Terrapin-Rocket-Team/Airbrake/Wiring_Diagram/Pictures/MotorControlerIn.png

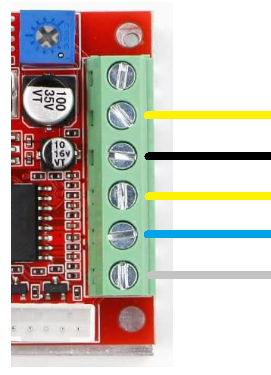
Wiring_Diagram/Pictures/MotorControlerIn.png
