Terrapin-Rocket-Team/Airbrake/Wiring_Diagram/Pictures/BlueRaven.png

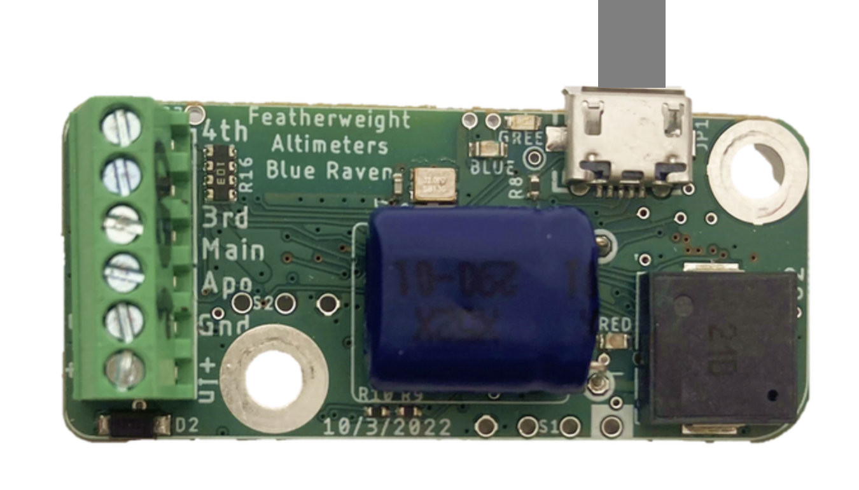
Wiring_Diagram/Pictures/BlueRaven.png
