Terrapin-Rocket-Team/Airbrake/Astra-Rocket/hitl_altitude_comparison.png

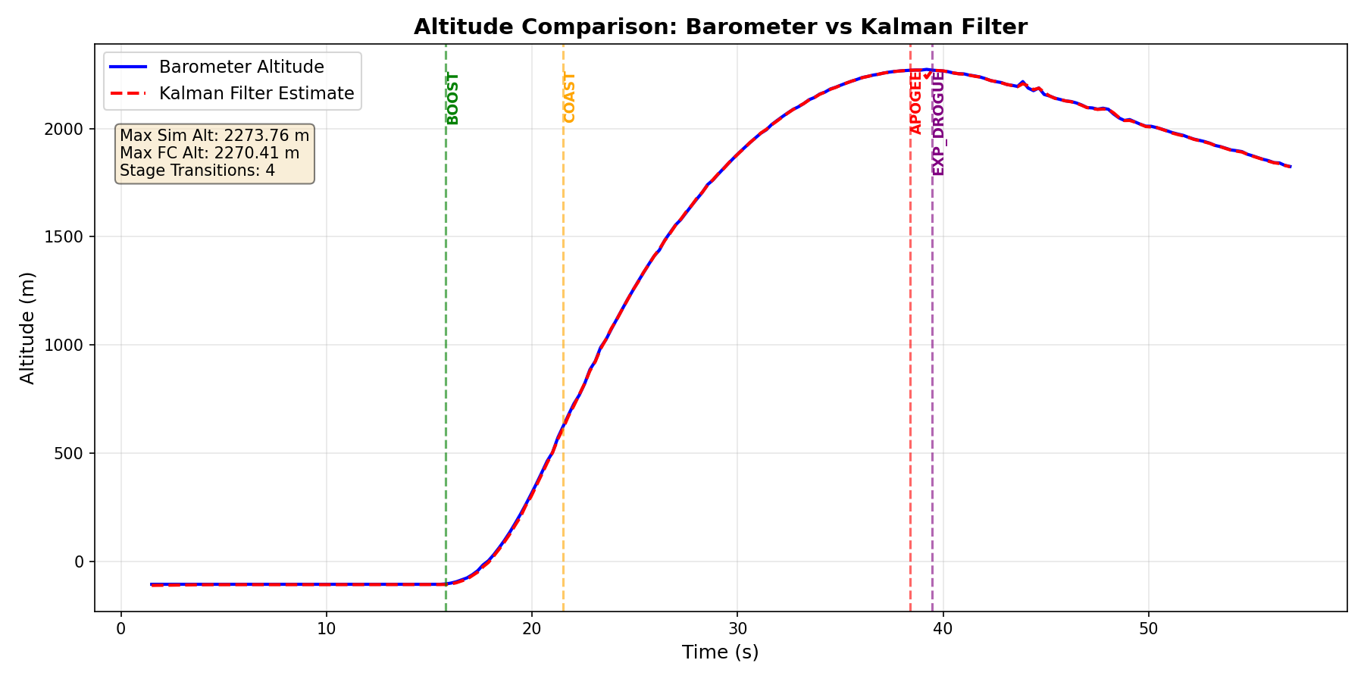
Astra-Rocket/hitl_altitude_comparison.png
