Terrapin-Rocket-Team/Airbrake/flap_force/Force_Geometry.png

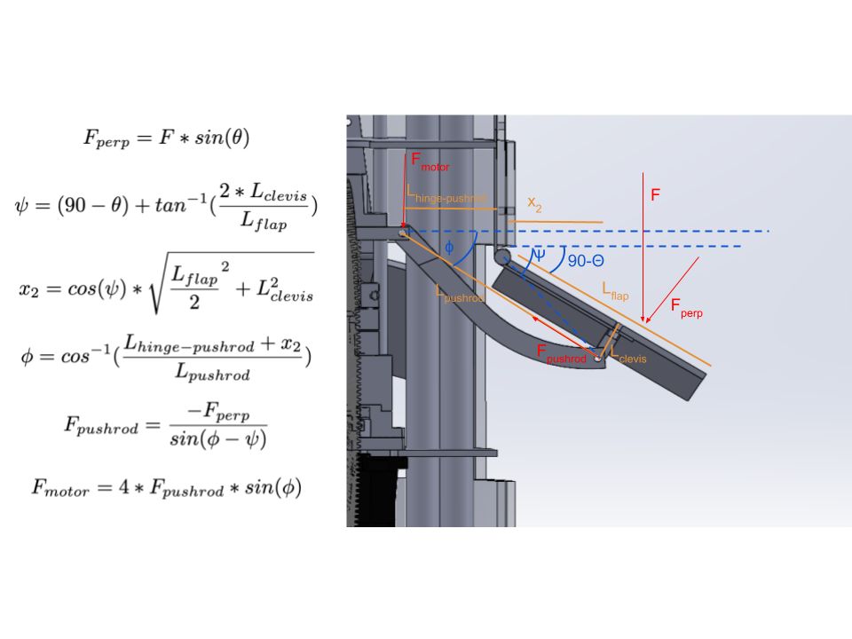
flap_force/Force_Geometry.png
