Terrapin-Rocket-Team/Airbrake/flap_force/output/max_flap_angle_vs_drag_force.png

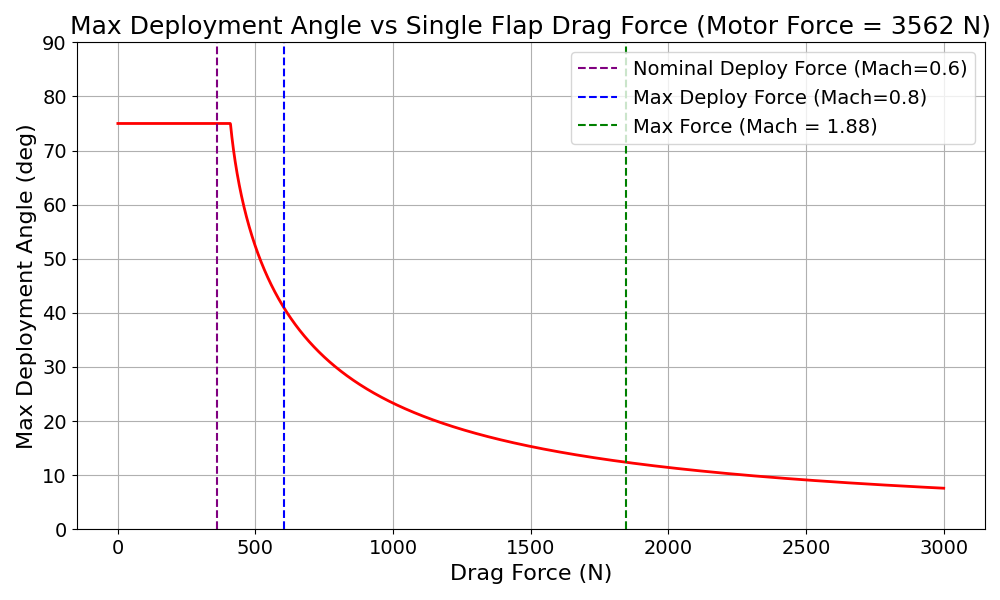
flap_force/output/max_flap_angle_vs_drag_force.png
