Terrapin-Rocket-Team/Airbrake/HITL/graphs/5-22-25_Interior_Full_plot.png

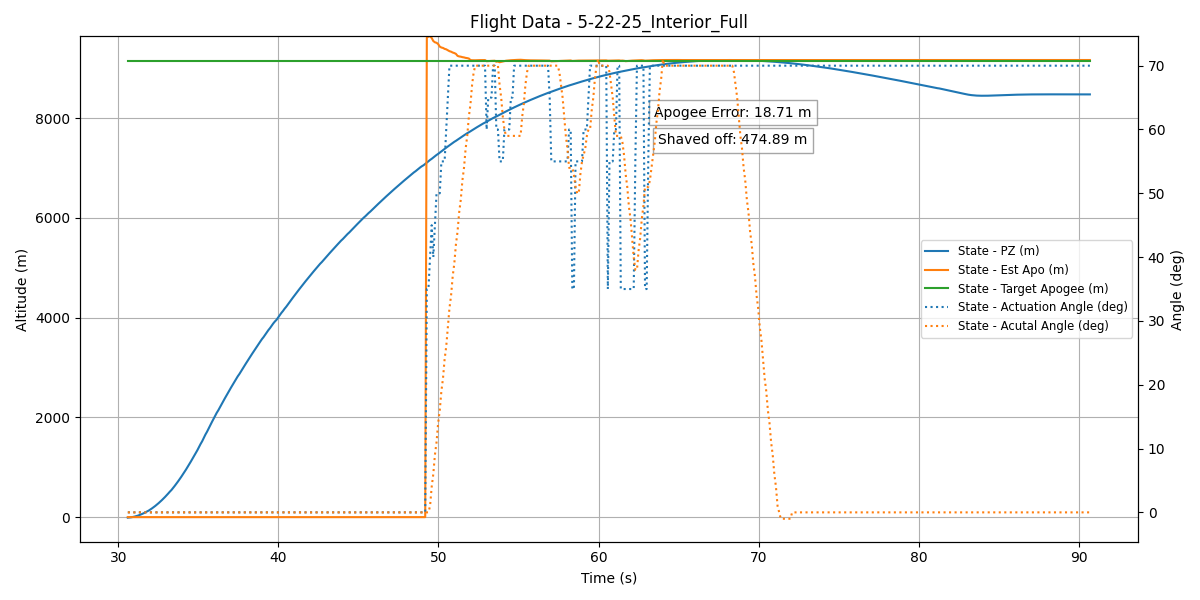
HITL/graphs/5-22-25_Interior_Full_plot.png
