Terrapin-Rocket-Team/Airbrake/HITL/graphs/5-22-25_No_Flap_plot.png

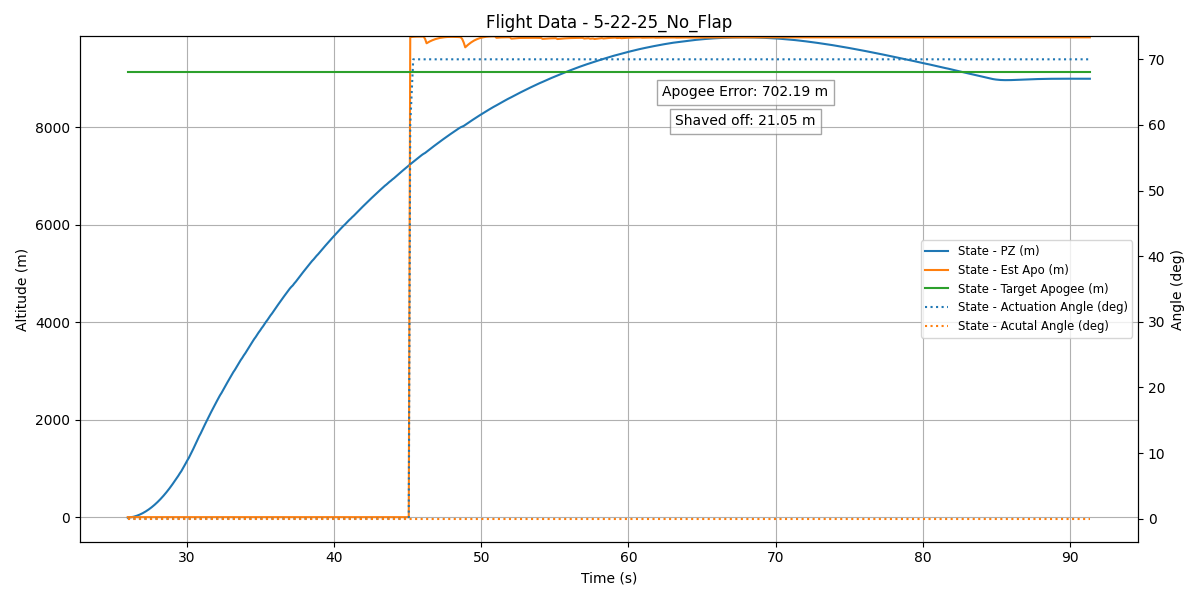
HITL/graphs/5-22-25_No_Flap_plot.png
