Terrapin-Rocket-Team/Airbrake/HITL/graphs/5-25-25_fixed_CdA_estimation_plot.png

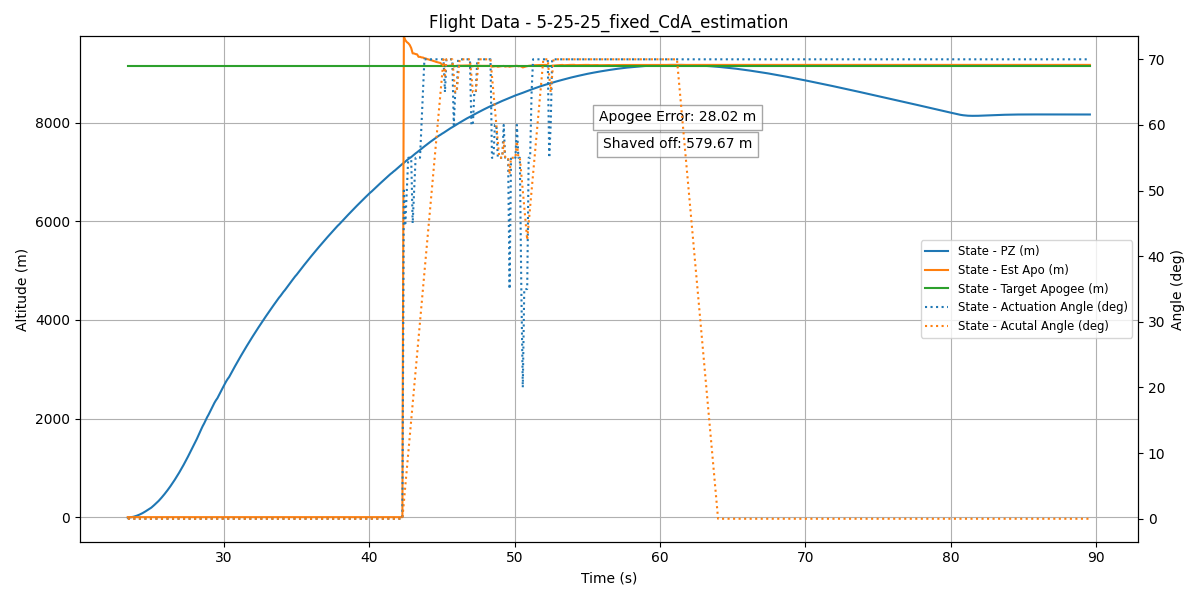
HITL/graphs/5-25-25_fixed_CdA_estimation_plot.png
