Terrapin-Rocket-Team/Airbrake/HITL/graphs/5-31-25_supersonic_not_accounted_for_plot.png

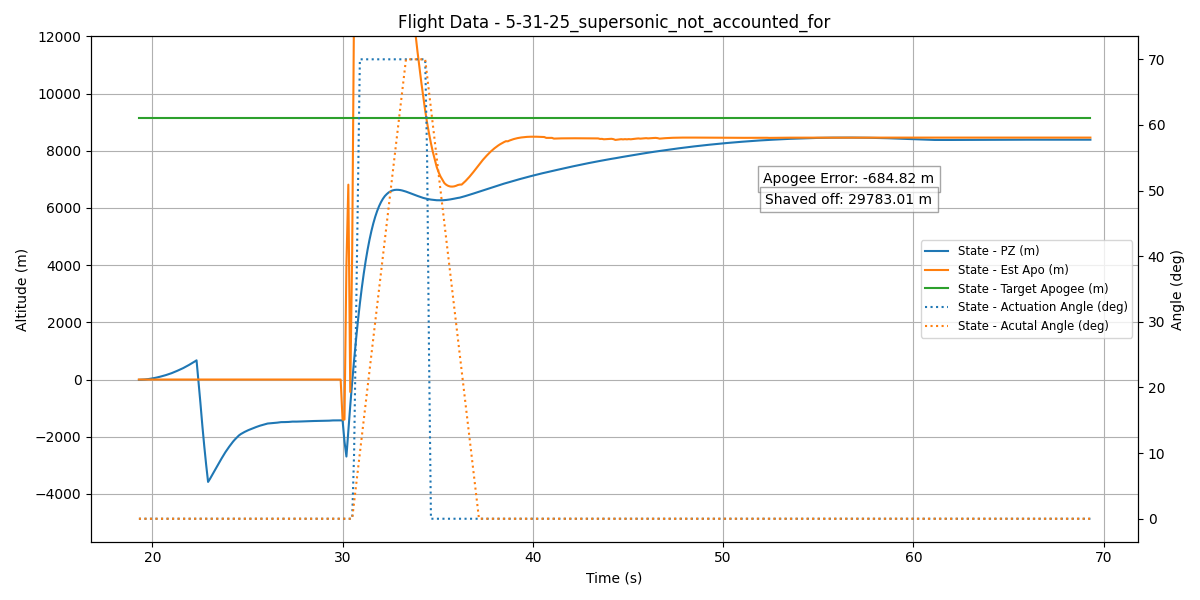
HITL/graphs/5-31-25_supersonic_not_accounted_for_plot.png
