Terrapin-Rocket-Team/Airbrake/HITL/graphs/5-31-25_supersonic_simple_filter_plot.png

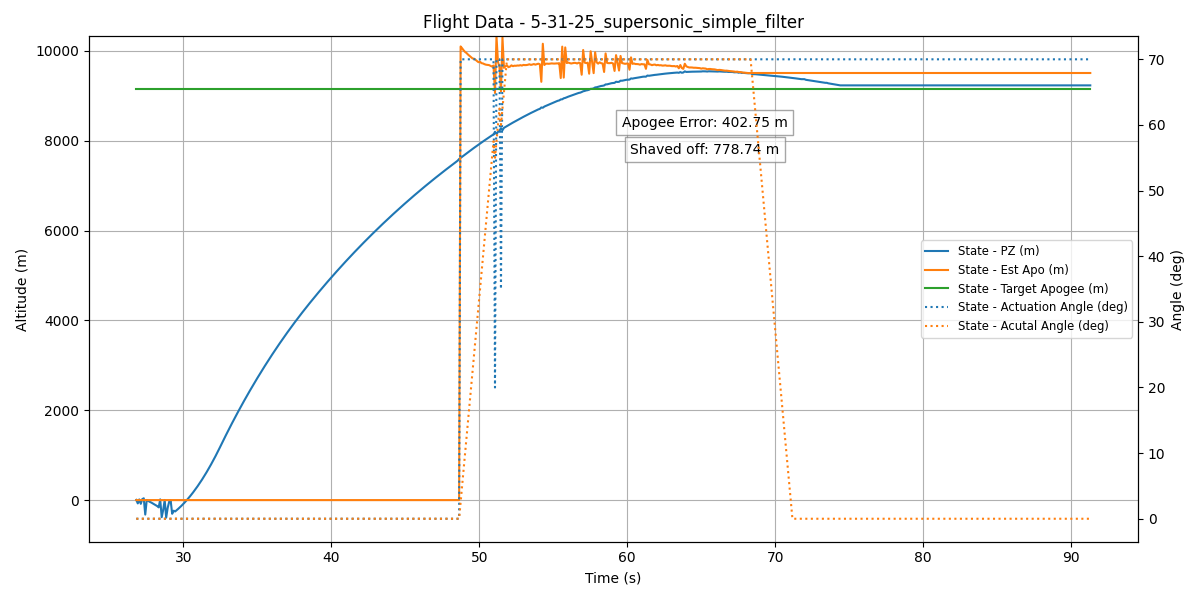
HITL/graphs/5-31-25_supersonic_simple_filter_plot.png
