Terrapin-Rocket-Team/Airbrake/HITL/graphs/6-6-25_full_airbrake_no_supersonic_plot.png

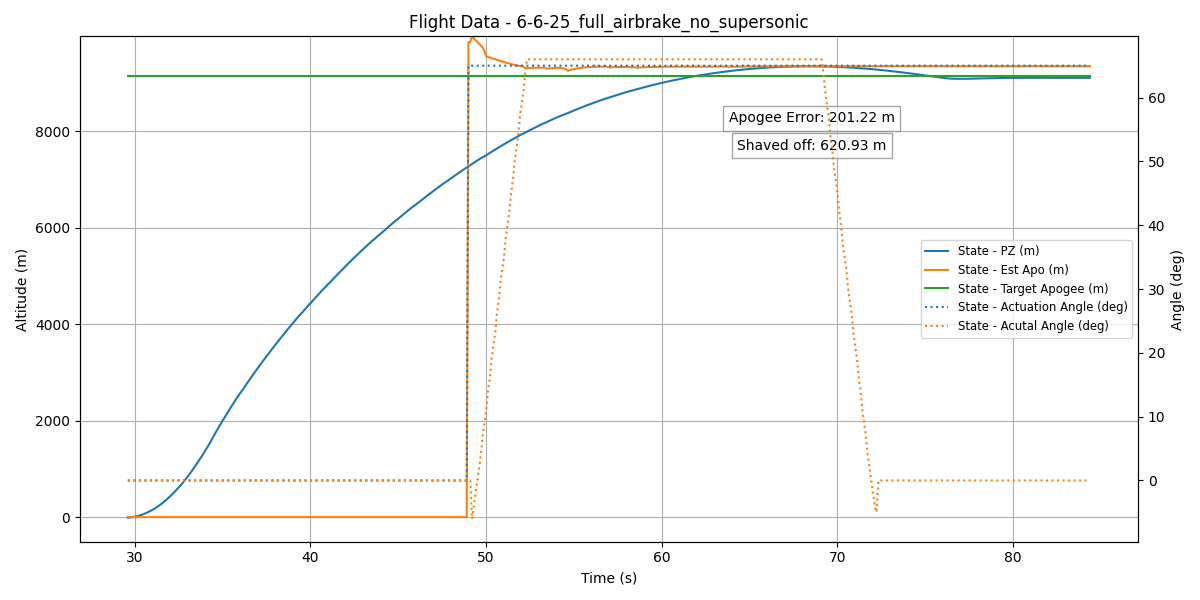
HITL/graphs/6-6-25_full_airbrake_no_supersonic_plot.png
