Terrapin-Rocket-Team/Airbrake/HITL/graphs/6-8-25_full_airbrake_ideal_plot.png

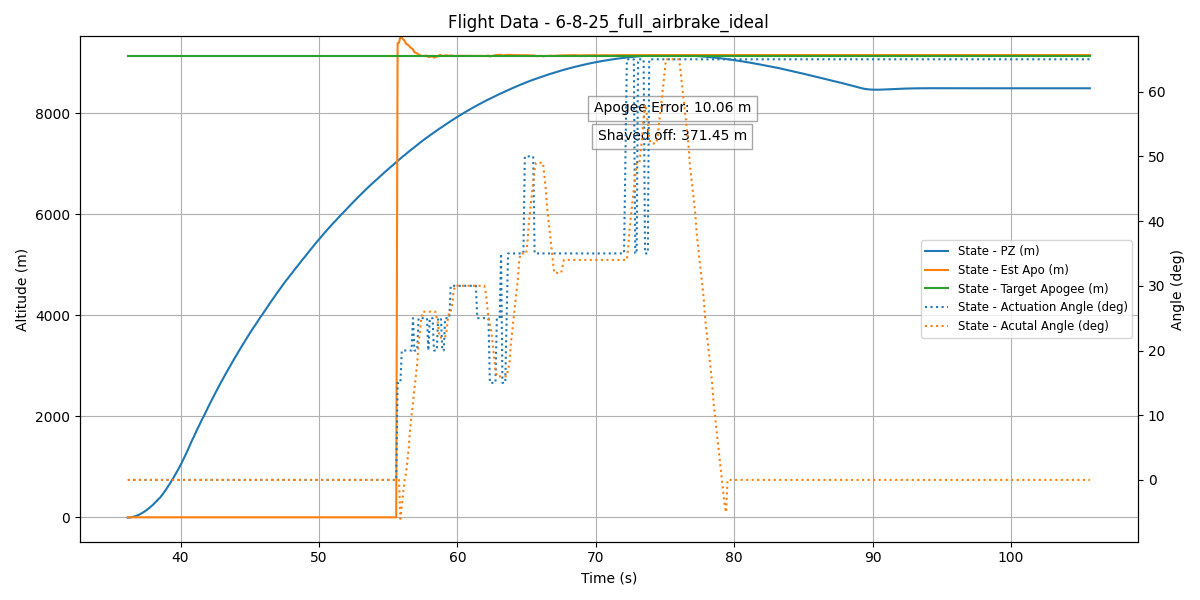
HITL/graphs/6-8-25_full_airbrake_ideal_plot.png
