Terrapin-Rocket-Team/Airbrake/HITL/graphs/6-8-25_ideal_again_plot.png

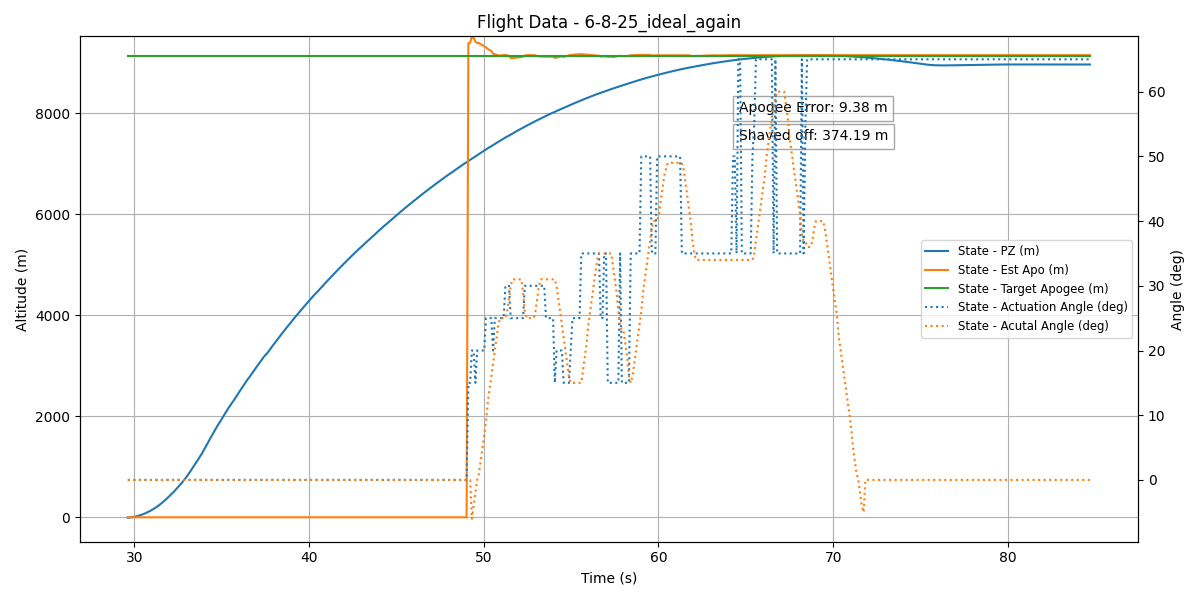
HITL/graphs/6-8-25_ideal_again_plot.png
