Terrapin-Rocket-Team/Airbrake/HITL/graphs/6-8-25_ideal_full_flight_plot.png

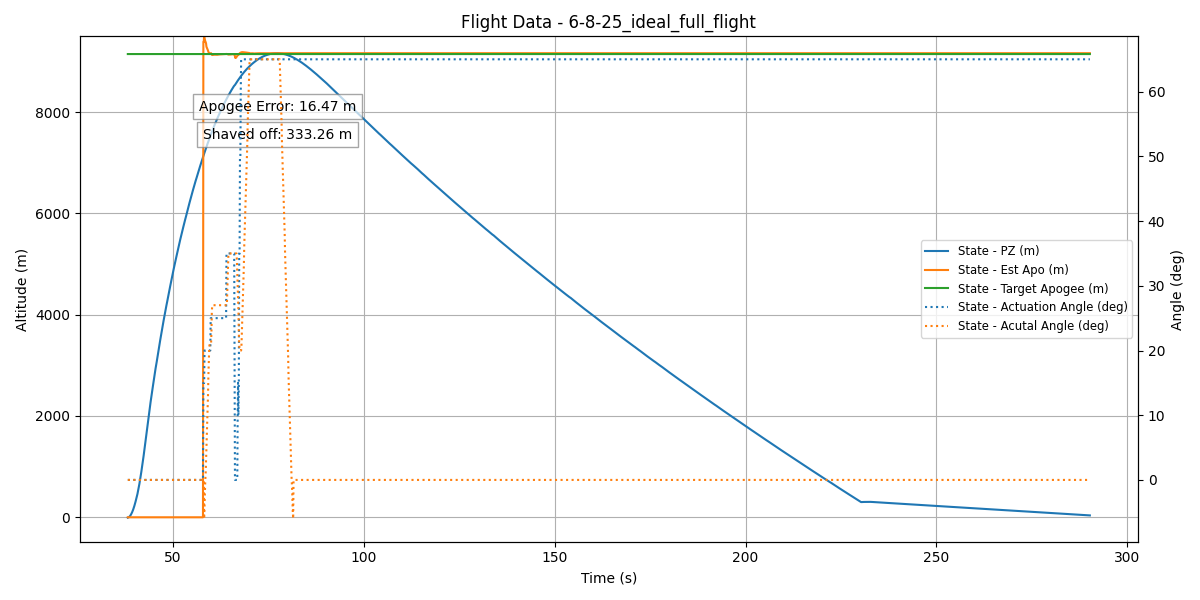
HITL/graphs/6-8-25_ideal_full_flight_plot.png
