Terrapin-Rocket-Team/Airbrake/HITL/graphs/6-8-25_worst_case_motor_plot.png

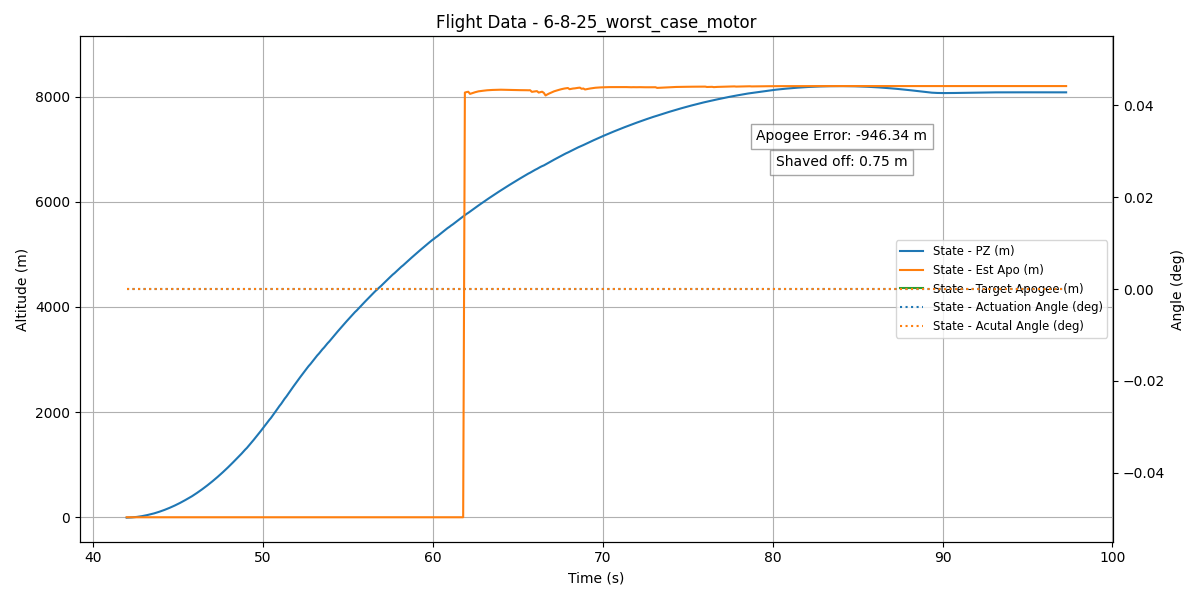
HITL/graphs/6-8-25_worst_case_motor_plot.png
