Terrapin-Rocket-Team/Airbrake/HITL/graphs/6-10-25_final_simulation_plot.png

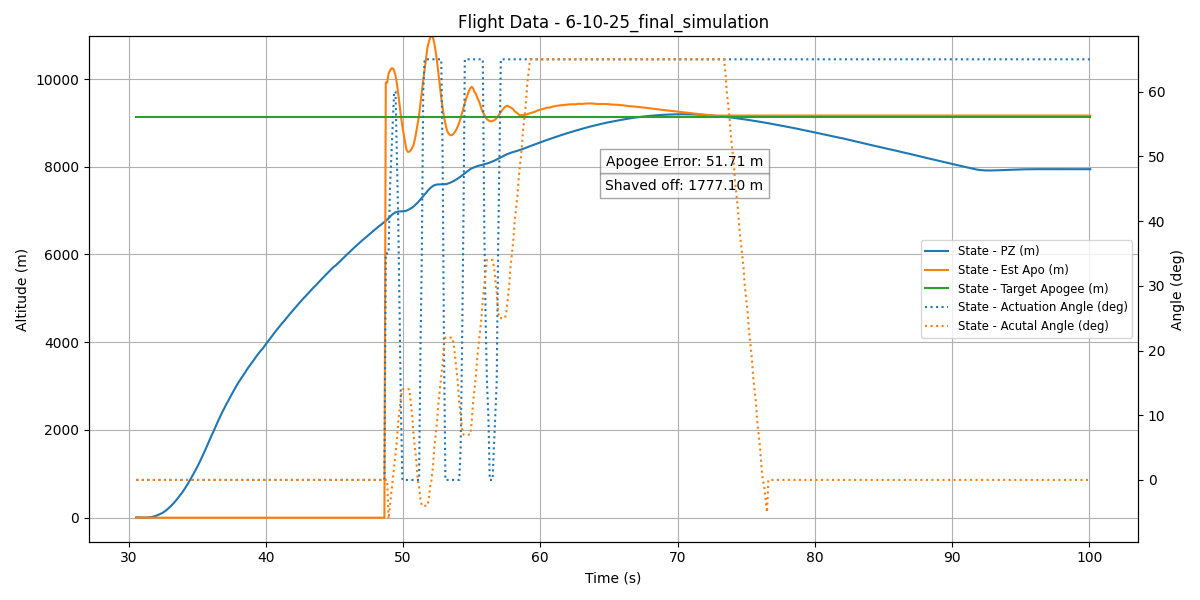
HITL/graphs/6-10-25_final_simulation_plot.png
