Terrapin-Rocket-Team/Airbrake/HITL/graphs/HITL-Airbrake_plot.png

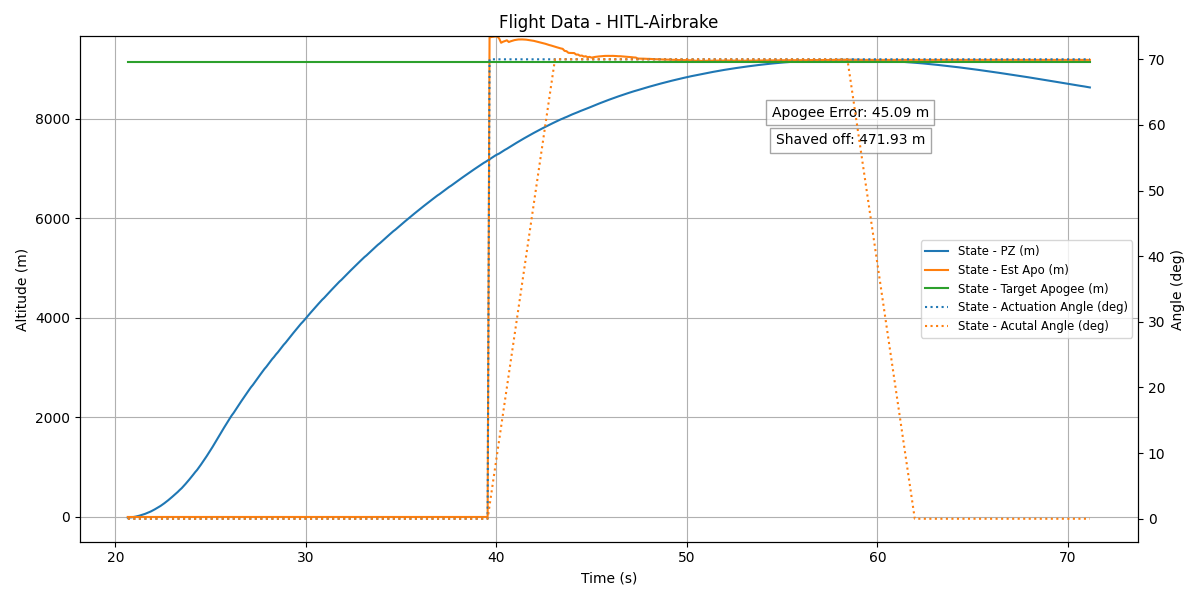
HITL/graphs/HITL-Airbrake_plot.png
