Terrapin-Rocket-Team/Airbrake/Concept_ CAD/Assembly.SLDASM

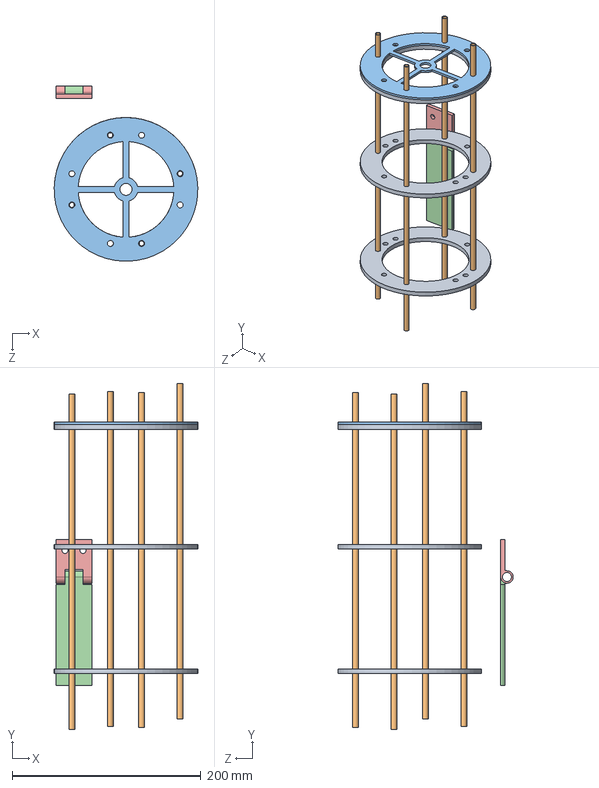
[picture p20: CAD file, 2024-07-18]
Concept_ CAD/Assembly.SLDASM
152.3 x 366.9 x 186.1 mm
Bulkhead x 3
Carbon_Fibre_Rod x 4
Bulkhead_Top
Hinge_Bottom
Hinge_Top
