Terrapin-Rocket-Team/Airbrake/Concept_ CAD/Flap_Assembly.SLDASM

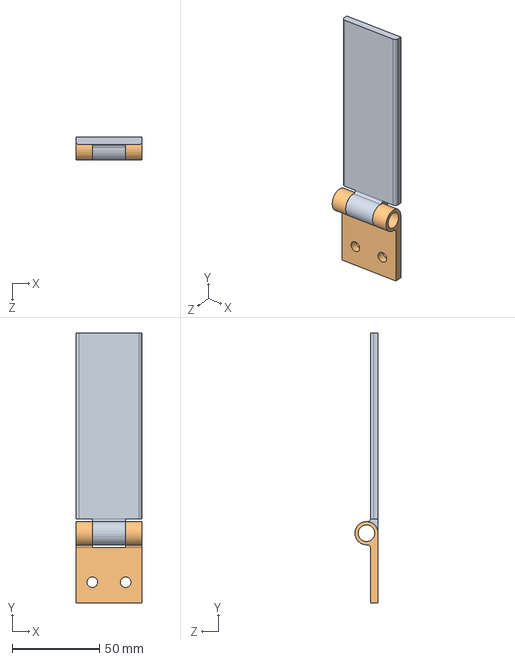
[picture p21: CAD file, 2024-07-18]
Concept_ CAD/Flap_Assembly.SLDASM
38.1 x 154.9 x 13.3 mm
Hinge_Bottom
Hinge_Top
