Terrapin-Rocket-Team/Airbrake/PCBs/Airbrake_ComputeBoard/Airbrake_ComputeBoard_v1_2.step

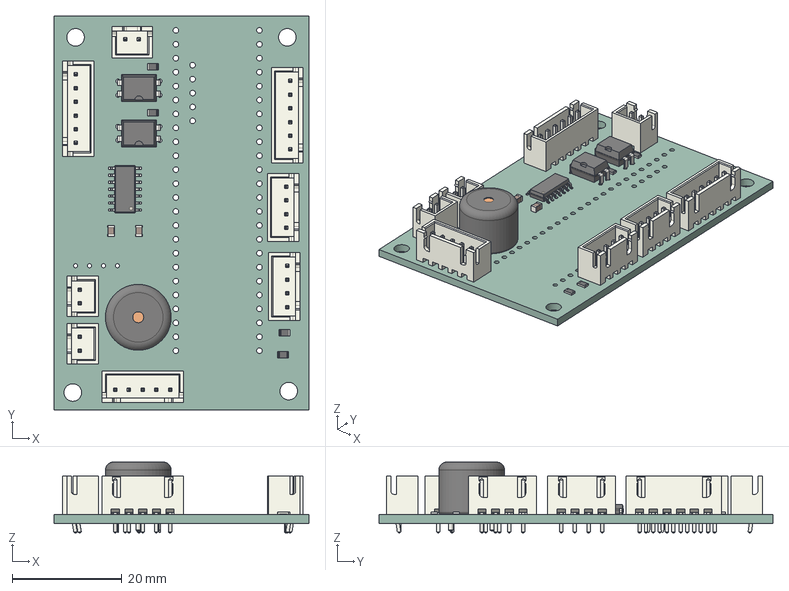
[picture p22: CAD file, 2024-12-22]
PCBs/Airbrake_ComputeBoard/Airbrake_ComputeBoard_v1_2.step
46.5 x 71.8 x 12.9 mm
DIP-4_W7.62mm x 2
JST_B5B_XH_A
SOIC_14_39x87mm_P127mm
Buzzer_12x95RM76
R_0805_2012Metric x 4
JST_B6B_XH_A x 2
C_0805_2012Metric x 2
JST_B2B_XH_A x 3
JST_B4B_XH_A x 2
Airbrake_ComputeBoard_PCB
