Terrapin-Rocket-Team/Airbrake/TRT2303 - Airbrake/Air brake assembly/STEP/Flap_top.stp

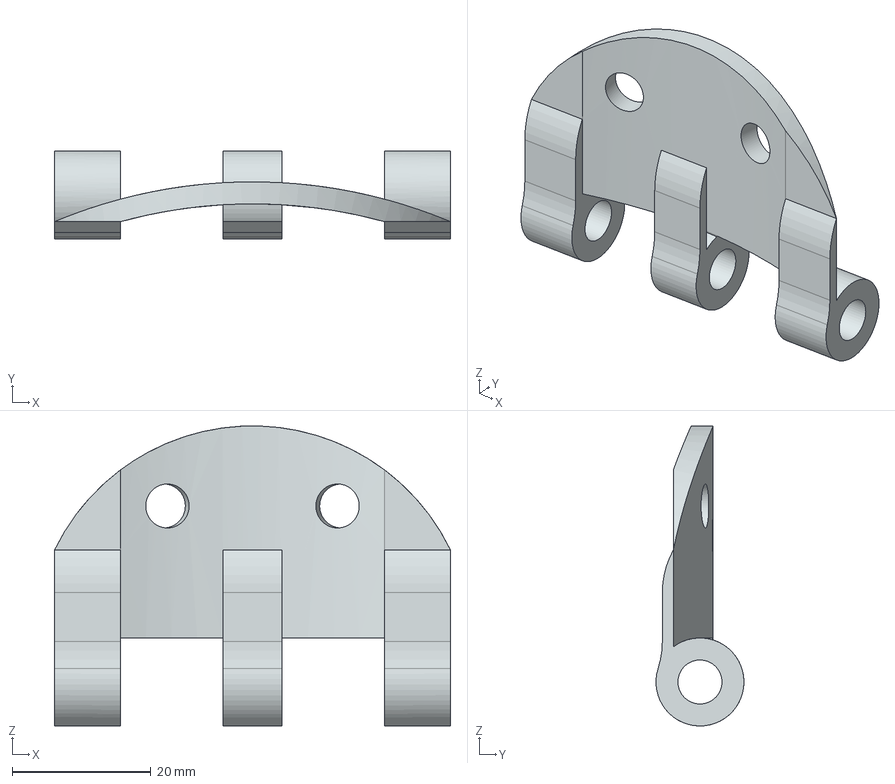
[picture p23: CAD file, 2024-07-18]
TRT2303 - Airbrake/Air brake assembly/STEP/Flap_top.stp
57.2 x 12.7 x 43.3 mm
