Terrapin-Rocket-Team/Airbrake/TRT2303 - Airbrake/Air brake assembly/stl/sting_hole_guide.stl

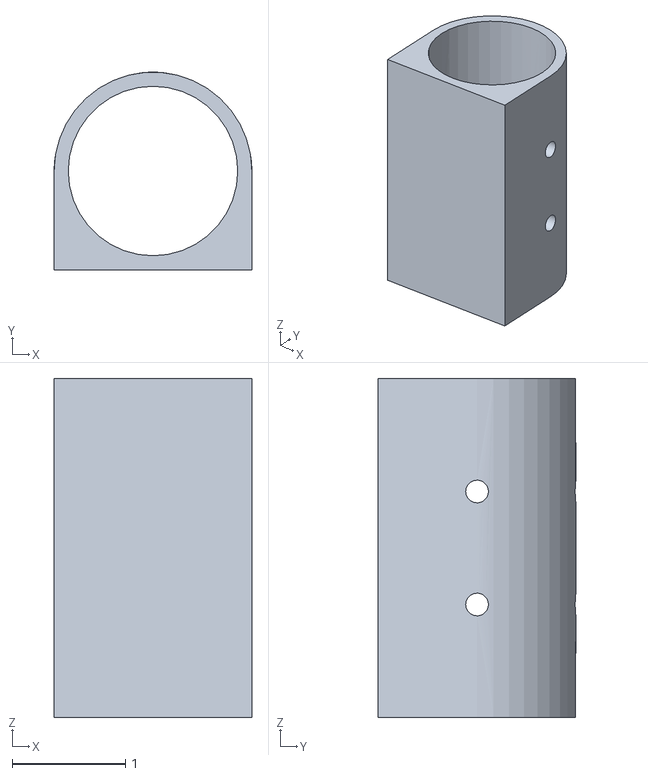
[picture p24: CAD file, 2024-07-18]
TRT2303 - Airbrake/Air brake assembly/stl/sting_hole_guide.stl
1.75 x 1.75 x 3.00
