Terrapin-Rocket-Team/Airbrake/TRT2303 - Airbrake/New Parts/inner bulkhead.STL

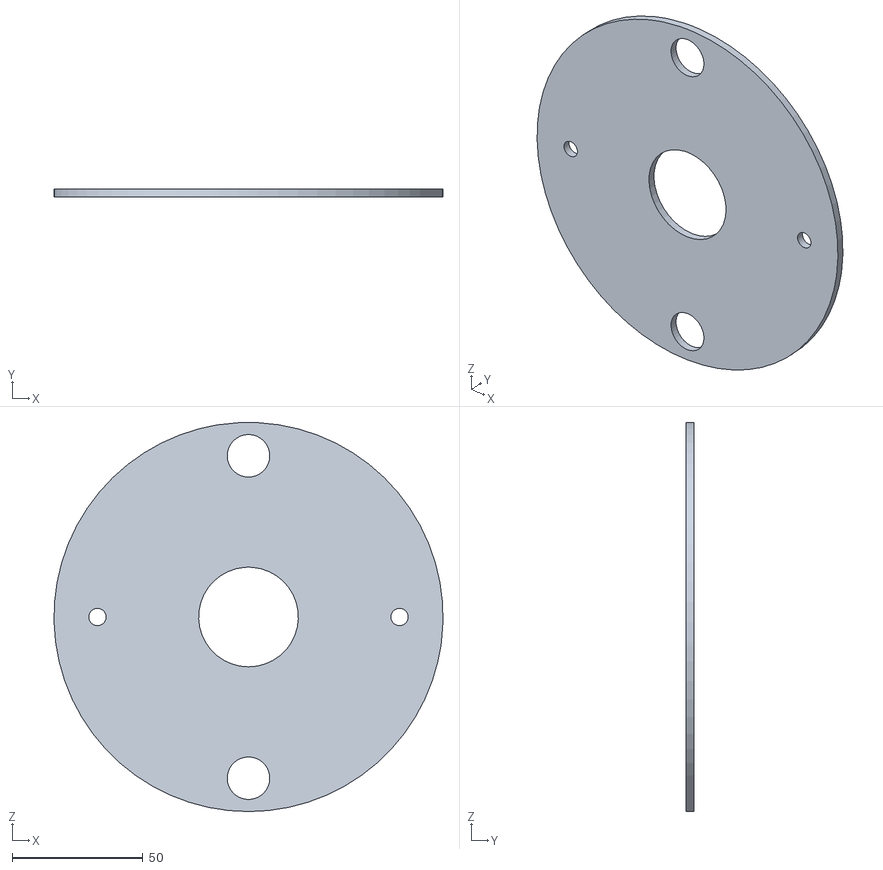
[picture p25: CAD file, 2024-07-18]
TRT2303 - Airbrake/New Parts/inner bulkhead.STL
148.7 x 3.17 x 148.7
