Terrapin-Rocket-Team/Airbrake/TRT2303 - Airbrake/Wind tunnel test stand/DXF files/lower_recovery_tube_centering_ring.dxf

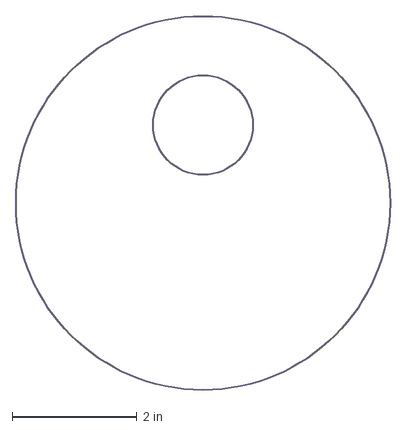
[picture p26: CAD file, 2024-07-18]
TRT2303 - Airbrake/Wind tunnel test stand/DXF files/lower_recovery_tube_centering_ring.dxf
6.00 x 6.00 in
