Terrapin-Rocket-Team/Airbrake/Concept_ CAD/Carbon_Fibre_Rod.SLDPRT

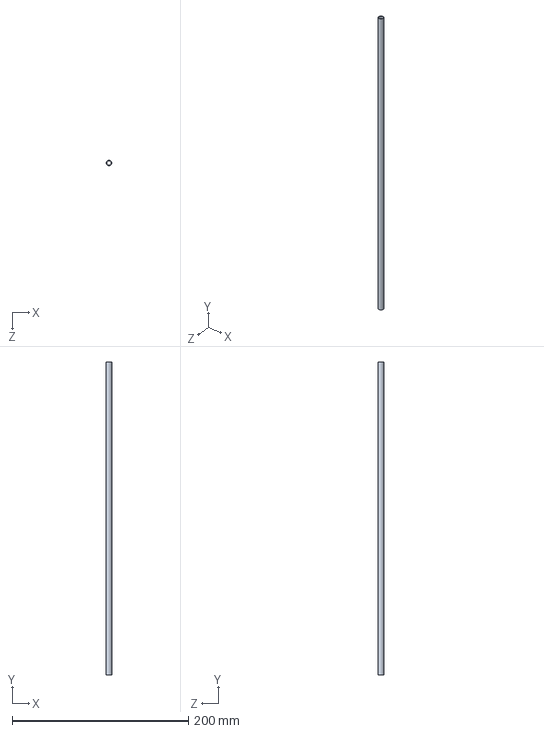
[picture p27: CAD file, 2024-07-18]
Concept_ CAD/Carbon_Fibre_Rod.SLDPRT
6.35 x 355.6 x 6.35 mm
