Terrapin-Rocket-Team/Airbrake/TRT2303 - Airbrake/Air brake assembly/STEP/Flap_bottom.stp

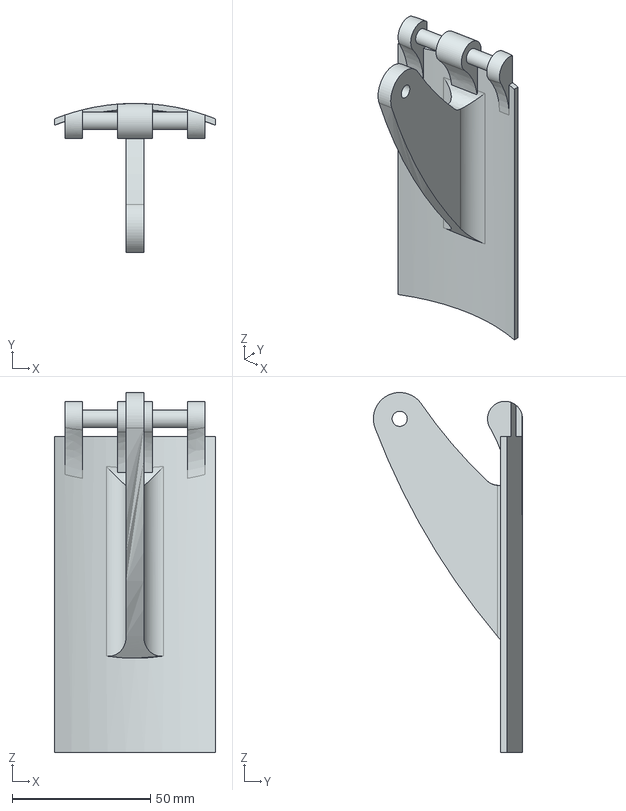
[picture p28: CAD file, 2024-07-18]
TRT2303 - Airbrake/Air brake assembly/STEP/Flap_bottom.stp
58.3 x 54.0 x 130.2 mm
