Terrapin-Rocket-Team/Airbrake/Concept_ CAD/Bulkhead_Top.SLDPRT

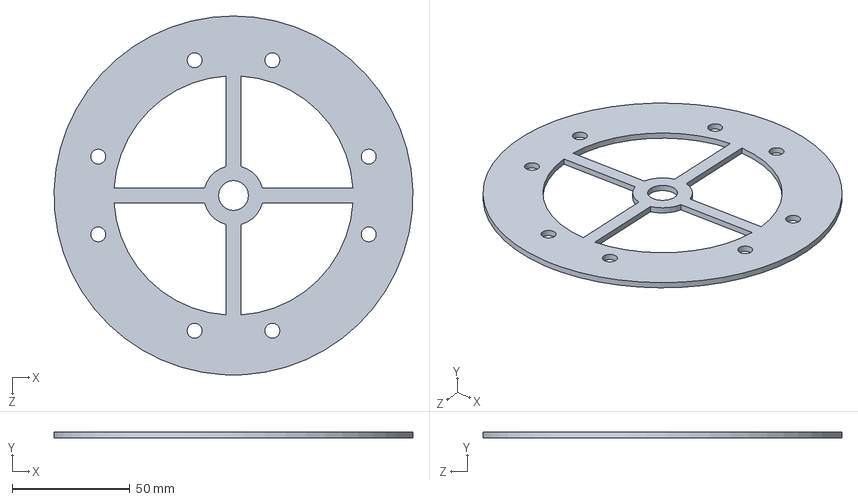
[picture p29: CAD file, 2024-07-18]
Concept_ CAD/Bulkhead_Top.SLDPRT
152.3 x 2.54 x 152.4 mm
