Terrapin-Rocket-Team/Airbrake/TRT2303 - Airbrake/Air brake assembly/Coupler.stp

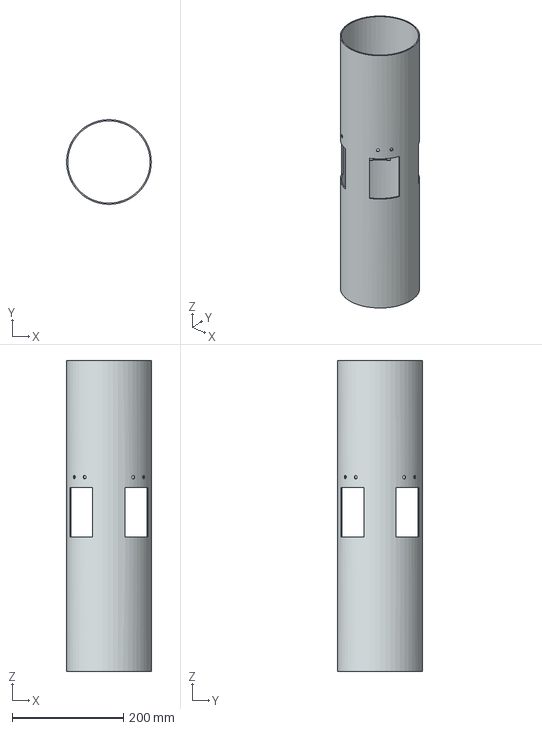
[picture p30: CAD file, 2024-07-18]
TRT2303 - Airbrake/Air brake assembly/Coupler.stp
152.2 x 152.3 x 558.8 mm
