Terrapin-Rocket-Team/Airbrake/TRT2303 - Airbrake/Air brake assembly/STEP/flap horn and hinge.stp

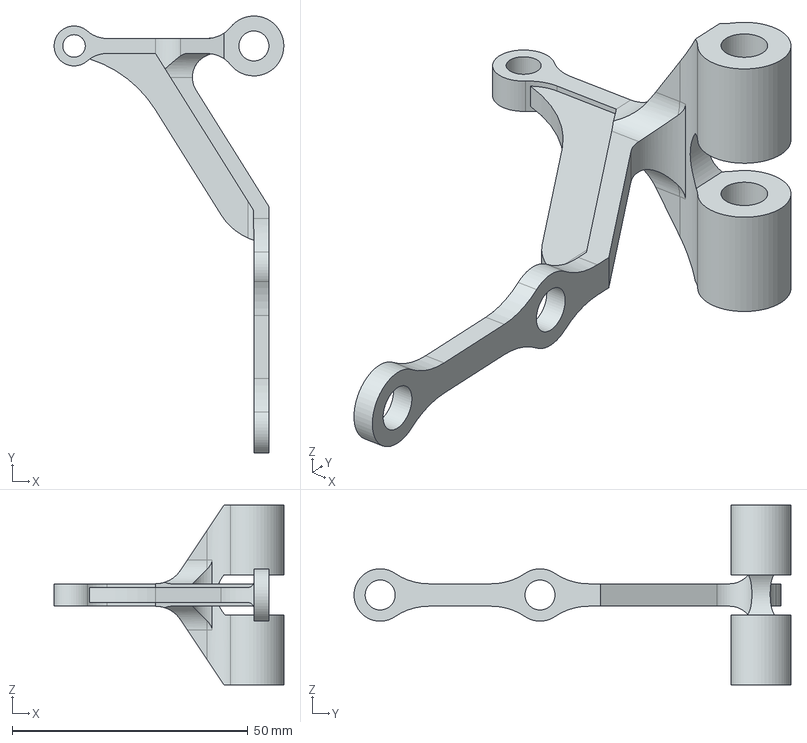
[picture p31: CAD file, 2024-07-18]
TRT2303 - Airbrake/Air brake assembly/STEP/flap horn and hinge.stp
48.7 x 92.6 x 38.1 mm
