Terrapin-Rocket-Team/Airbrake/Concept_ CAD/Hinge_Top.SLDPRT

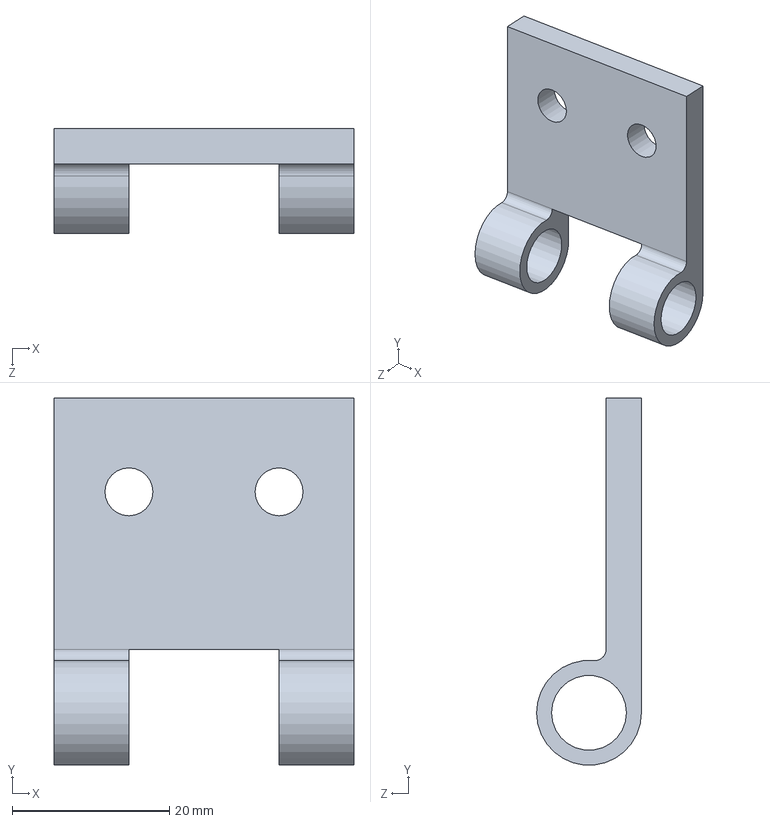
[picture p32: CAD file, 2024-07-18]
Concept_ CAD/Hinge_Top.SLDPRT
38.1 x 46.7 x 13.3 mm
