Terrapin-Rocket-Team/Airbrake/TRT2303 - Airbrake/Air brake assembly/BEAM.SLDPRT

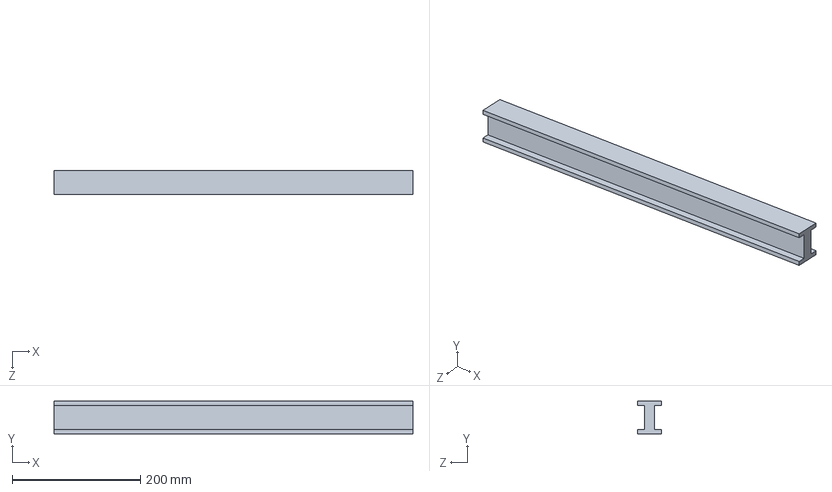
[picture p33: CAD file, 2024-07-18]
TRT2303 - Airbrake/Air brake assembly/BEAM.SLDPRT
558.8 x 50.8 x 38.1 mm
