Terrapin-Rocket-Team/Airbrake/Concept_ CAD/Hinge_Bottom.SLDPRT

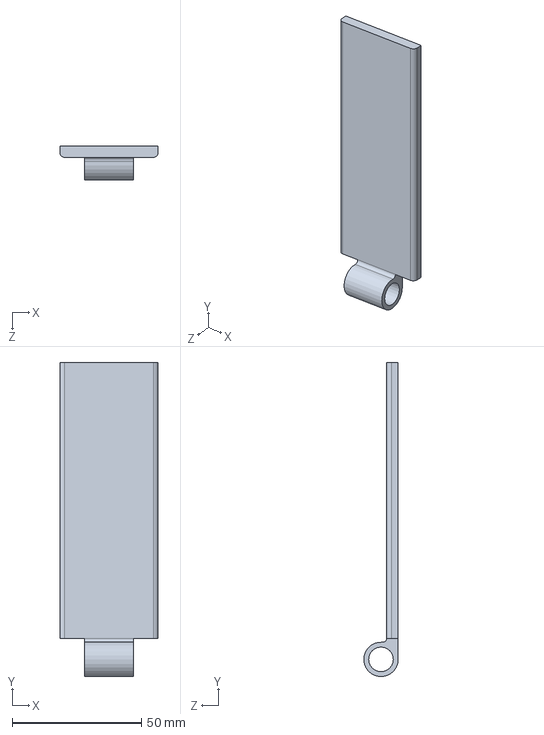
[picture p34: CAD file, 2024-07-18]
Concept_ CAD/Hinge_Bottom.SLDPRT
38.1 x 121.5 x 13.3 mm
