Terrapin-Rocket-Team/Airbrake/Concept_ CAD/Bulkhead.SLDPRT

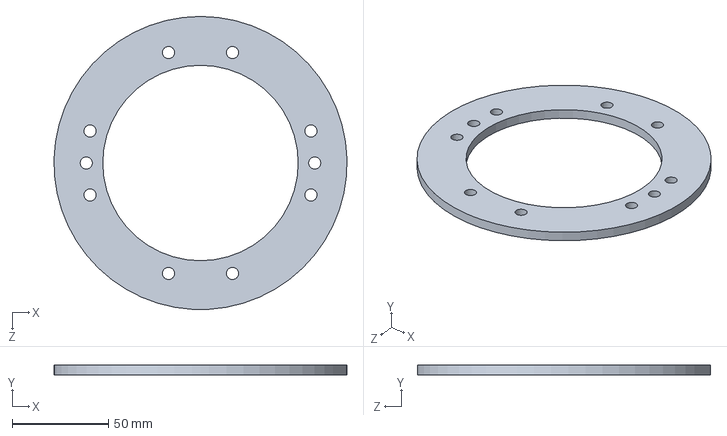
[picture p35: CAD file, 2024-07-18]
Concept_ CAD/Bulkhead.SLDPRT
152.3 x 5.08 x 152.4 mm
