Terrapin-Rocket-Team/Airbrake/sophie_CAD/half_asm.SLDASM

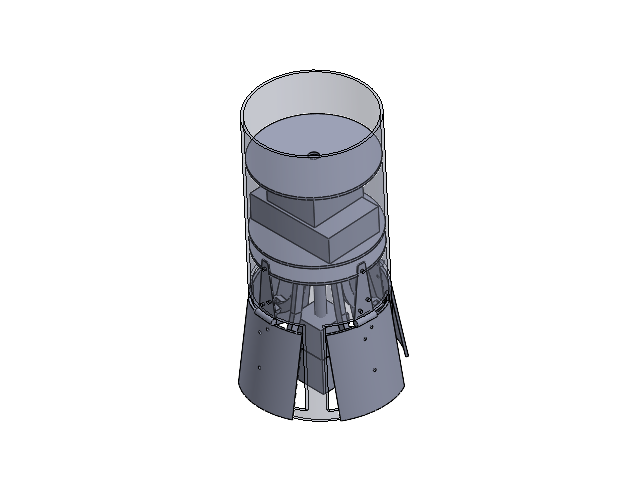
[picture p36: CAD file, 2024-09-17]
sophie_CAD/half_asm.SLDASM
central
wrench_arm x 4
flap_clevis x 4
new_body_tube
top_plate x 3
central_rod
mcmaster_half_hinge x 8
new_flap x 4
motor_battery
motor_driver
motor
gearbox
