Terrapin-Rocket-Team/Airbrake/(list of files, cad)

Other CAD files:
TRT2303 - Airbrake/Air brake assembly/Airbrake Assembly.stp
TRT2303 - Airbrake/Air brake assembly/stl/sting_hole_guide_1p51.stl
TRT2303 - Airbrake/Air brake assembly/1434K43_Mounted Roller Bearing with Two-Bolt Flange.prt
TRT2303 - Airbrake/Air brake assembly/4s Lipos.prt
TRT2303 - Airbrake/Air brake assembly/6071K11_Clevis Rod End.STEP
TRT2303 - Airbrake/Air brake assembly/6071K11_Clevis Rod End.prt
TRT2303 - Airbrake/Air brake assembly/6071K11_Clevis Rod End2073.prt
TRT2303 - Airbrake/Air brake assembly/6338K422_Oil-Embedded Flanged Sleeve Bearing.prt
TRT2303 - Airbrake/Air brake assembly/6483K53_Flange-Mounted Linear Ball Bearing.prt
TRT2303 - Airbrake/Air brake assembly/90128A248_Zinc-Plated Alloy Steel Socket Head Screw 20mm.prt
TRT2303 - Airbrake/Air brake assembly/90576A104_Medium-Strength Steel Nylon-Insert Locknut.prt
TRT2303 - Airbrake/Air brake assembly/90866A129_Zinc-Plated Steel Wing Nut.prt
TRT2303 - Airbrake/Air brake assembly/91090A107_Zinc-Plated Steel Oversized Washer.prt
TRT2303 - Airbrake/Air brake assembly/91290A230_Black-Oxide Alloy Steel Socket Head Screw 14mm.prt
TRT2303 - Airbrake/Air brake assembly/92196A107_18-8 Stainless Steel Socket Head Screw 4_40___5_16.prt
TRT2303 - Airbrake/Air brake assembly/92210A537_18-8 Stainless Steel Hex Drive Flat Head Screw.prt
TRT2303 - Airbrake/Air brake assembly/92510A455_Aluminum Unthreaded Spacer.prt
TRT2303 - Airbrake/Air brake assembly/92510A455_Aluminum Unthreaded Spacer87.prt
TRT2303 - Airbrake/Air brake assembly/92949A540_18-8 Stainless Steel Button Head Hex Drive Screw.prt
TRT2303 - Airbrake/Air brake assembly/98381A551_Dowel Pin.prt
TRT2303 - Airbrake/Air brake assembly/Actuator Screw Tool.prt
TRT2303 - Airbrake/Air brake assembly/AirBrake Coupler.prt
TRT2303 - Airbrake/Air brake assembly/Airbrake Assembly.prt
TRT2303 - Airbrake/Air brake assembly/Aluminum Unthreaded Spacer.prt
TRT2303 - Airbrake/Air brake assembly/BEAM.SLDDRW
TRT2303 - Airbrake/Air brake assembly/Ball Bearing.prt
TRT2303 - Airbrake/Air brake assembly/Clevis Pin.prt
TRT2303 - Airbrake/Air brake assembly/Coupler.prt
TRT2303 - Airbrake/Air brake assembly/Ebay Assembly.prt
TRT2303 - Airbrake/Air brake assembly/Ebay Partition.prt
TRT2303 - Airbrake/Air brake assembly/Ebay sled.prt
TRT2303 - Airbrake/Air brake assembly/Electronics_Sled.prt
TRT2303 - Airbrake/Air brake assembly/Flange Nut.prt
TRT2303 - Airbrake/Air brake assembly/Flap Assembly.prt
TRT2303 - Airbrake/Air brake assembly/Flap_bottom.prt
TRT2303 - Airbrake/Air brake assembly/Flap_top.prt
TRT2303 - Airbrake/Air brake assembly/Flap_top_fem1_i.prt
TRT2303 - Airbrake/Air brake assembly/HP 98-10240 Motor.prt
TRT2303 - Airbrake/Air brake assembly/Inner Tube.prt
TRT2303 - Airbrake/Air brake assembly/Lead Screw Flange Nut.prt
TRT2303 - Airbrake/Air brake assembly/LiPo.prt
TRT2303 - Airbrake/Air brake assembly/Linear screw guard.prt
TRT2303 - Airbrake/Air brake assembly/Linear_Actuator.prt
TRT2303 - Airbrake/Air brake assembly/Lower bulkhead top.prt
TRT2303 - Airbrake/Air brake assembly/Main Battery.prt
TRT2303 - Airbrake/Air brake assembly/Medium-Strength Steel Hex Nut p25 in.prt
TRT2303 - Airbrake/Air brake assembly/Nozzle Lock Ring.prt
TRT2303 - Airbrake/Air brake assembly/Nozzle O-Ring.prt
TRT2303 - Airbrake/Air brake assembly/Nozzle.prt
TRT2303 - Airbrake/Air brake assembly/Outer Tube.prt
TRT2303 - Airbrake/Air brake assembly/PCB board.prt
TRT2303 - Airbrake/Air brake assembly/Propellant 1.prt
TRT2303 - Airbrake/Air brake assembly/Propellant 2.prt
TRT2303 - Airbrake/Air brake assembly/Spacer.prt
TRT2303 - Airbrake/Air brake assembly/Stepper Drive.prt
TRT2303 - Airbrake/Air brake assembly/Top Cyl 1.prt
TRT2303 - Airbrake/Air brake assembly/Top Cyl 2.prt
TRT2303 - Airbrake/Air brake assembly/Top Cyl.prt
TRT2303 - Airbrake/Air brake assembly/Top O-Rings.prt
TRT2303 - Airbrake/Air brake assembly/Top Ring.prt
TRT2303 - Airbrake/Air brake assembly/Top.prt
TRT2303 - Airbrake/Air brake assembly/WGT_fairing.prt
TRT2303 - Airbrake/Air brake assembly/actuator disk 6in.prt
TRT2303 - Airbrake/Air brake assembly/actuator mounting plate.prt
TRT2303 - Airbrake/Air brake assembly/actuator rod comp.prt
TRT2303 - Airbrake/Air brake assembly/actuator rod competition.prt
TRT2303 - Airbrake/Air brake assembly/actuator rod hinge.prt
TRT2303 - Airbrake/Air brake assembly/actuator rod nuts.prt
TRT2303 - Airbrake/Air brake assembly/actuator rod v2.prt
TRT2303 - Airbrake/Air brake assembly/actuator rod.prt
TRT2303 - Airbrake/Air brake assembly/clevis rod end v2.prt
TRT2303 - Airbrake/Air brake assembly/coupler_dwg1.prt
TRT2303 - Airbrake/Air brake assembly/driver.prt
TRT2303 - Airbrake/Air brake assembly/eslad_assembly.prt
TRT2303 - Airbrake/Air brake assembly/flap horn and hinge.prt
TRT2303 - Airbrake/Air brake assembly/flapV2.prt
TRT2303 - Airbrake/Air brake assembly/flapV2_assembly.prt
TRT2303 - Airbrake/Air brake assembly/lower bulkhead bottom.prt
TRT2303 - Airbrake/Air brake assembly/screw_switch.prt
TRT2303 - Airbrake/Air brake assembly/shockcord tube.prt
TRT2303 - Airbrake/Air brake assembly/stp-le23-3h06ann.prt
TRT2303 - Airbrake/Air brake assembly/switchband.prt
TRT2303 - Airbrake/Air brake assembly/threaded_rod.prt
TRT2303 - Airbrake/Air brake assembly/upper bulkhead bottom.prt
TRT2303 - Airbrake/Air brake assembly/upper bulkhead top.prt
TRT2303 - Airbrake/Air brake assembly/wire_guard_tube.prt
TRT2303 - Airbrake/Wind tunnel test stand/1434K43_Mounted Roller Bearing with Two-Bolt Flange.prt
TRT2303 - Airbrake/Wind tunnel test stand/2in Nosecone Tip.prt
TRT2303 - Airbrake/Wind tunnel test stand/4in straight cone mold.prt
TRT2303 - Airbrake/Wind tunnel test stand/4s Lipos.prt
TRT2303 - Airbrake/Wind tunnel test stand/6071K11_Clevis Rod End.prt
TRT2303 - Airbrake/Wind tunnel test stand/6338K422_Oil-Embedded Flanged Sleeve Bearing.prt
TRT2303 - Airbrake/Wind tunnel test stand/6483K53_Flange-Mounted Linear Ball Bearing.prt
TRT2303 - Airbrake/Wind tunnel test stand/8896T82_304 Stainless Steel U-Bolt.prt
TRT2303 - Airbrake/Wind tunnel test stand/90128A248_Zinc-Plated Alloy Steel Socket Head Screw 20mm.prt
TRT2303 - Airbrake/Wind tunnel test stand/90576A104_Medium-Strength Steel Nylon-Insert Locknut.prt
TRT2303 - Airbrake/Wind tunnel test stand/90866A129_Zinc-Plated Steel Wing Nut.prt
TRT2303 - Airbrake/Wind tunnel test stand/91090A107_Zinc-Plated Steel Oversized Washer.prt
TRT2303 - Airbrake/Wind tunnel test stand/91290A230_Black-Oxide Alloy Steel Socket Head Screw 14mm.prt
TRT2303 - Airbrake/Wind tunnel test stand/92196A107_18-8 Stainless Steel Socket Head Screw 4_40___5_16.prt
TRT2303 - Airbrake/Wind tunnel test stand/92510A455_Aluminum Unthreaded Spacer.prt
TRT2303 - Airbrake/Wind tunnel test stand/92510A455_Aluminum Unthreaded Spacer87.prt
TRT2303 - Airbrake/Wind tunnel test stand/92949A540_18-8 Stainless Steel Button Head Hex Drive Screw.prt
TRT2303 - Airbrake/Wind tunnel test stand/Actuator Screw Tool.prt
TRT2303 - Airbrake/Wind tunnel test stand/AirBrake Coupler.prt
TRT2303 - Airbrake/Wind tunnel test stand/Airbrake Assembly.prt
TRT2303 - Airbrake/Wind tunnel test stand/Aluminum Unthreaded Spacer.prt
TRT2303 - Airbrake/Wind tunnel test stand/Ball Bearing.prt
TRT2303 - Airbrake/Wind tunnel test stand/Clevis Pin.prt
TRT2303 - Airbrake/Wind tunnel test stand/Coupler.prt
TRT2303 - Airbrake/Wind tunnel test stand/Ebay sled.prt
TRT2303 - Airbrake/Wind tunnel test stand/Ebay_Bulkhead.prt
TRT2303 - Airbrake/Wind tunnel test stand/Flange Nut.prt
TRT2303 - Airbrake/Wind tunnel test stand/Flap Assembly.prt
TRT2303 - Airbrake/Wind tunnel test stand/Flap_bottom.prt
TRT2303 - Airbrake/Wind tunnel test stand/Flap_top.prt
TRT2303 - Airbrake/Wind tunnel test stand/GLMWT_0029.prt
TRT2303 - Airbrake/Wind tunnel test stand/GLMWT_0065_PITCH_LINK_20in_Ben.prt
TRT2303 - Airbrake/Wind tunnel test stand/Lead Screw Flange Nut.prt
TRT2303 - Airbrake/Wind tunnel test stand/Linear screw guard.prt
TRT2303 - Airbrake/Wind tunnel test stand/Linear_Actuator.prt
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
