Terrapin-Rocket-Team/Airbrake/TRT2303 - Airbrake/Air brake assembly/2023 renders/flapV2_assembly_back.jpg

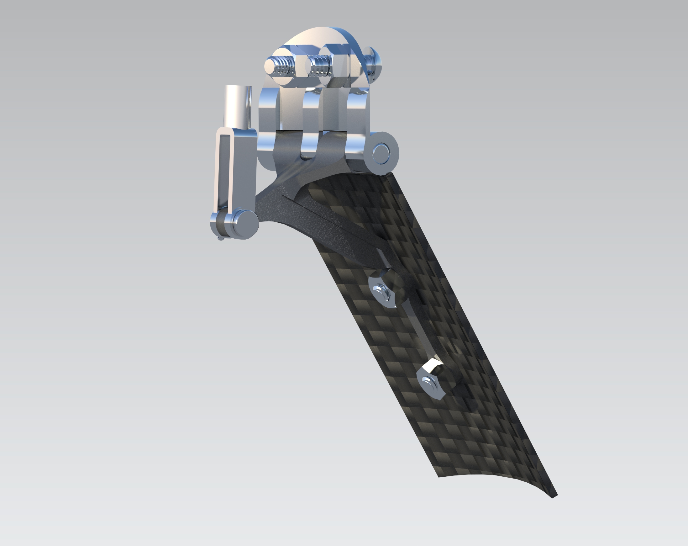
TRT2303 - Airbrake/Air brake assembly/2023 renders/flapV2_assembly_back.jpg
