Terrapin-Rocket-Team/Airbrake/TRT2303 - Airbrake/Air brake assembly/Airbrake Assembly skeleton.jpg

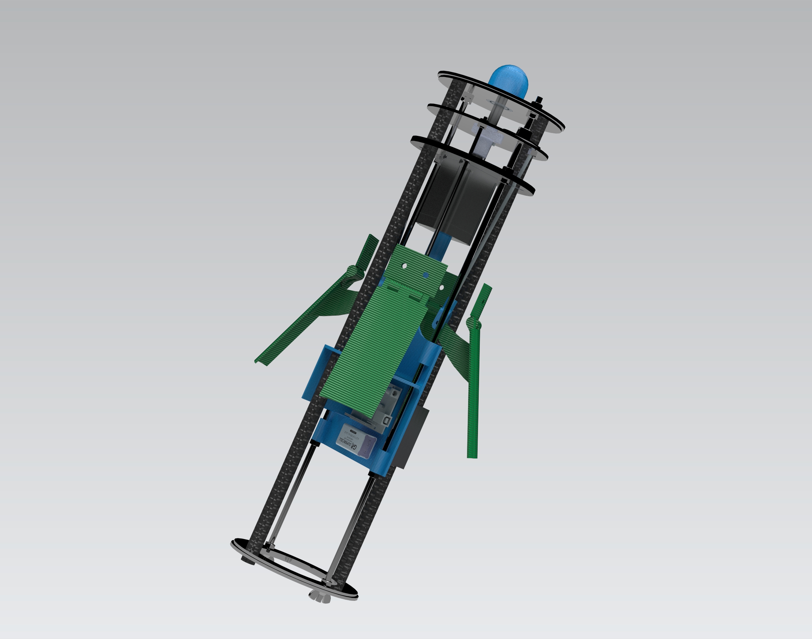
TRT2303 - Airbrake/Air brake assembly/Airbrake Assembly skeleton.jpg
