Terrapin-Rocket-Team/Airbrake/TRT2303 - Airbrake/Air brake assembly/ExportHighResolutionImage.jpg

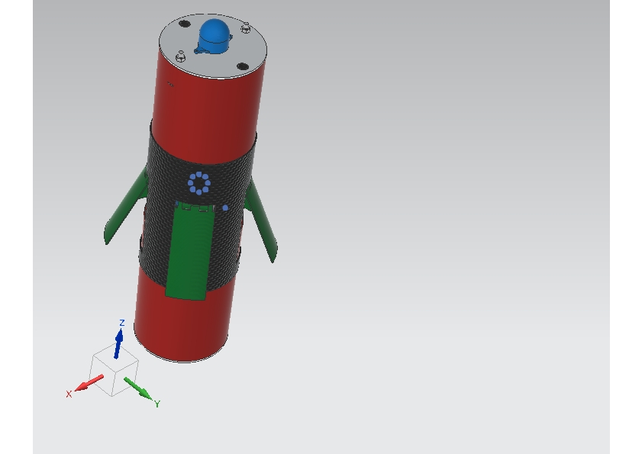
TRT2303 - Airbrake/Air brake assembly/ExportHighResolutionImage.jpg
