Terrapin-Rocket-Team/Airbrake/TRT2303 - Airbrake/Air brake assembly/Sparse Matrix Solver.png

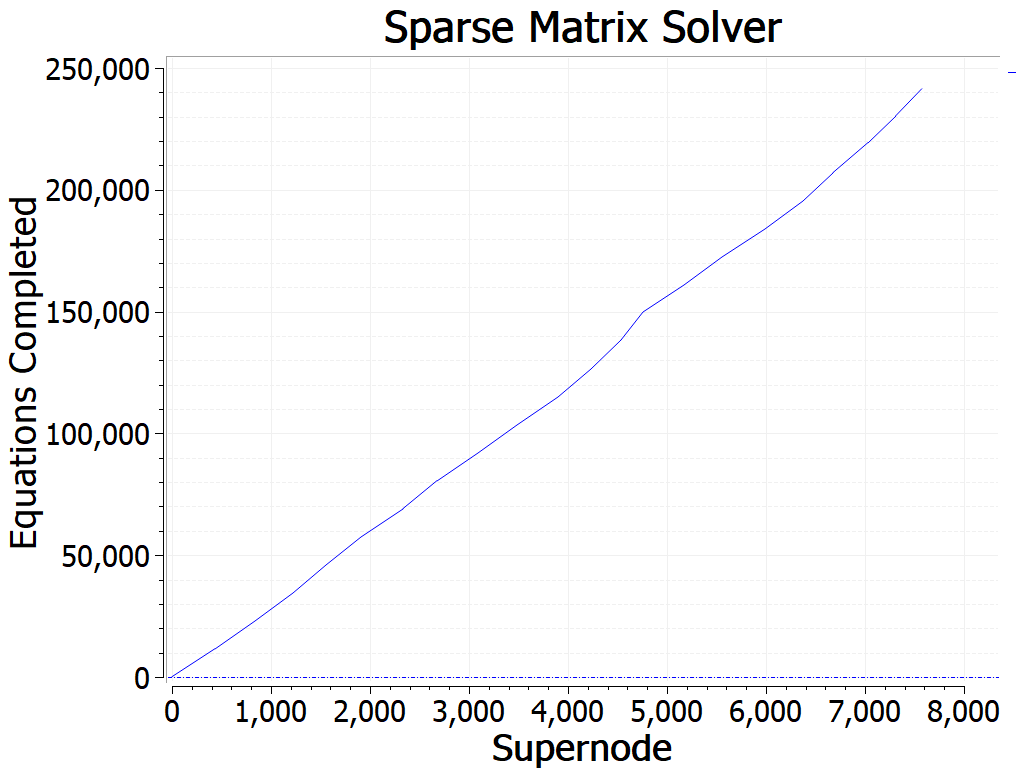
TRT2303 - Airbrake/Air brake assembly/Sparse Matrix Solver.png
