Terrapin-Rocket-Team/Airbrake/Wiring_Diagram/Airbrake.png

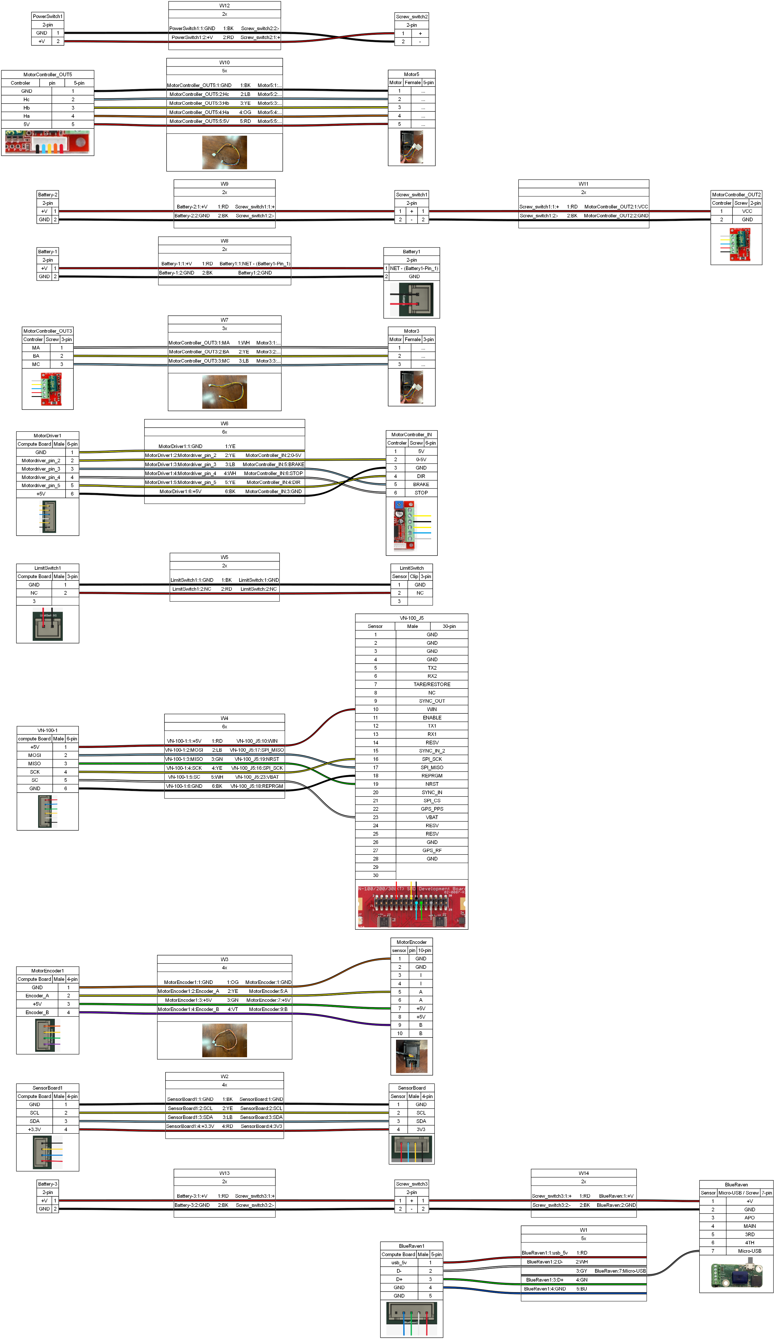
Wiring_Diagram/Airbrake.png
