Terrapin-Rocket-Team/Airbrake/Wiring_Diagram/Pictures/Motor_encoder.png

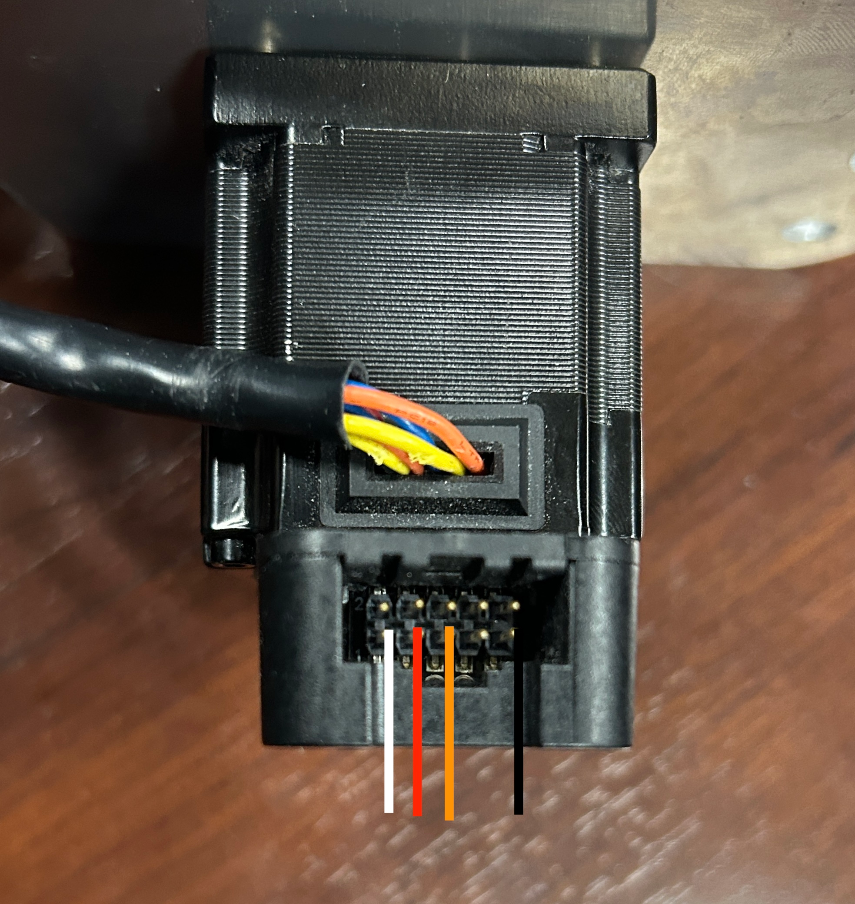
Wiring_Diagram/Pictures/Motor_encoder.png
