Terrapin-Rocket-Team/Airbrake/Wiring_Diagram/Pictures/MotorControlerOut.png

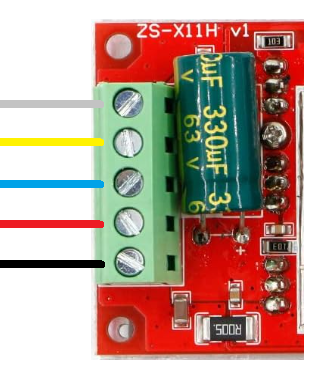
Wiring_Diagram/Pictures/MotorControlerOut.png
