Terrapin-Rocket-Team/Airbrake/Wiring_Diagram/Pictures/SensorBoard.png

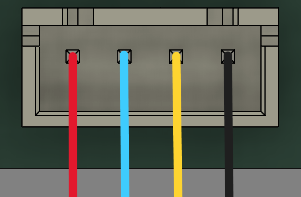
Wiring_Diagram/Pictures/SensorBoard.png
