Terrapin-Rocket-Team/Airbrake/Wiring_Diagram/Pictures/Vectornav-100-c.png

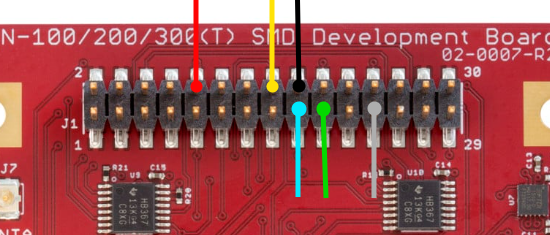
Wiring_Diagram/Pictures/Vectornav-100-c.png
