Terrapin-Rocket-Team/Airbrake/matlab_state_estimation/OpenRocketData/openrocket_test_data.csv

# Time (s) | Altitude (m) | Vertical velocity (m/s) | Vertical acceleration (m/s²) | Total velocity (m/s) | Total acceleration (m/s²) | Position East of launch (m) | Position North of launch (m) | Lateral distance (m) | Lateral direction (°) | Lateral velocity (m/s) | Lateral acceleration (m/s²) | Latitude (°) | Longitude (°) | Gravitational acceleration (m/s²) | Angle of attack (°) | Roll rate (r/s) | Pitch rate (r/s) | Yaw rate (r/s) | Mass (g) | Motor mass (g) | Longitudinal moment of inertia (kg·m²) | Rotational moment of inertia (kg·m²) | CP location (cm) | CG location (cm) | Stability margin calibers () | Mach number () | Reynolds number () | Thrust (N) | Drag force (N) | Drag coefficient () | Axial drag coefficient () | Friction drag coefficient () | Pressure drag coefficient () | Base drag coefficient () | Normal force coefficient () | Pitch moment coefficient () | Yaw moment coefficient () | Side force coefficient () | Roll moment coefficient () | Roll forcing coefficient () | Roll damping coefficient () | Pitch damping coefficient () | Coriolis acceleration (m/s²) | Reference length (cm) | Reference area (cm²) | Vertical orientation (zenith) (°) | Lateral orientation
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
