Terrapin-Rocket-Team/Airbrake/(threads)

Thread 30 (2025-09-29):

Integration of the new motor and driver

Danny61516, 2025-09-29:
Context:
We are using a new motor ([https://www.uavmodel.com/products/mad-5005-ipe-kv280-kv350-kv440-brushless-motor-for-rc-fpv-uav-drone-quadcopter-hexcopter-octcopter-for-rc-quadcopter-multicopter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](url)), motor controller ([https://shop.odriverobotics.com/products/odrive-s1](url)), and encoder ([https://shop.odriverobotics.com/collections/odrive-s1/products/odrive-rs485-magnetic-encoder](url)) this year in the hopes of improving our speed, weight, force.

Key Info:
Marc you probably no more about what you have to do then I do .....

Ideal Timeline: Finished by Oct 30

Thread 36 (2025-09-30):

Voltage Readout

Danny61516, 2025-09-30:
Context:
In our previous design of our airbrake, we had to manually pull the internals out of the airbrake tube in order to poke some exposed wires with a multimeter to read out the voltages of our batteries. This is wildly inefficient and inconvenient, so we are looking into ways to make this simpler.

Key Info:
This simply requires a way to safely measure the voltages of a battery without taking the airbrake fully out of the tube. This could simply be an additional wire that connects to the wires off of our batteries that then feed into a mounting header, where we can then measure the leads and the voltage.

Ideal Timeline: Finished by Oct 8
