Terrapin-Rocket-Team/Airbrake/TRT2303 - Airbrake/Air brake assembly/BEAM.pdf

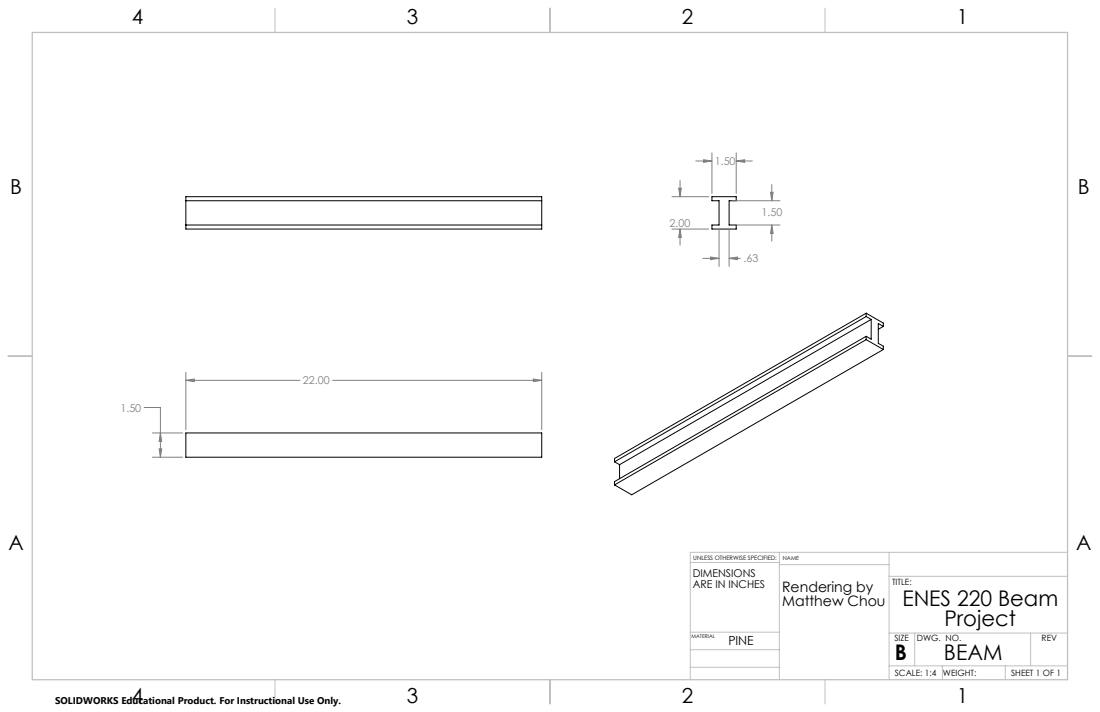
[picture p50: page 1]
ENES 220 Beam; SHEET 1 OF 1; SCALE: 1:4; WEIGHT:

UNLESS OTHERWISE SPECIFIED: | NAME
DIMENSIONS ARE IN INCHES | Matthew Chou | TITLE: Rendering by

PINE MATERIAL | | SIZE B | DWG. NO. BEAM | REV

SOLIDWORKS Educational Product. For Instructional Use Only.
