Terrapin-Rocket-Team/Airbrake/TRT2303 - Airbrake/Air brake assembly/ebreg_Airbrake Assembly.pdf

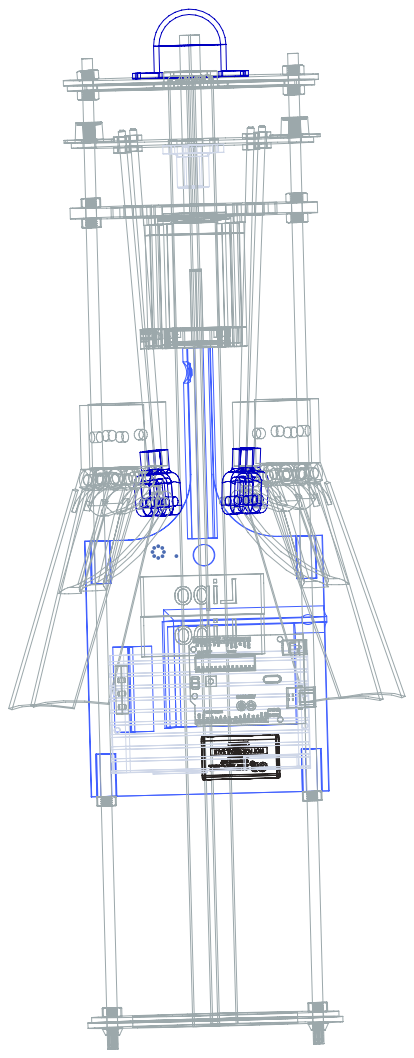
[picture p51: page 1]
