Terrapin-Rocket-Team/Airbrake/PCBs/Airbrake_ComputeBoard/Airbrake_ComputeBoard.kicad_pcb

## KiCad design PCBs/Airbrake_ComputeBoard/Airbrake_ComputeBoard.kicad_pcb (2024-12-22)

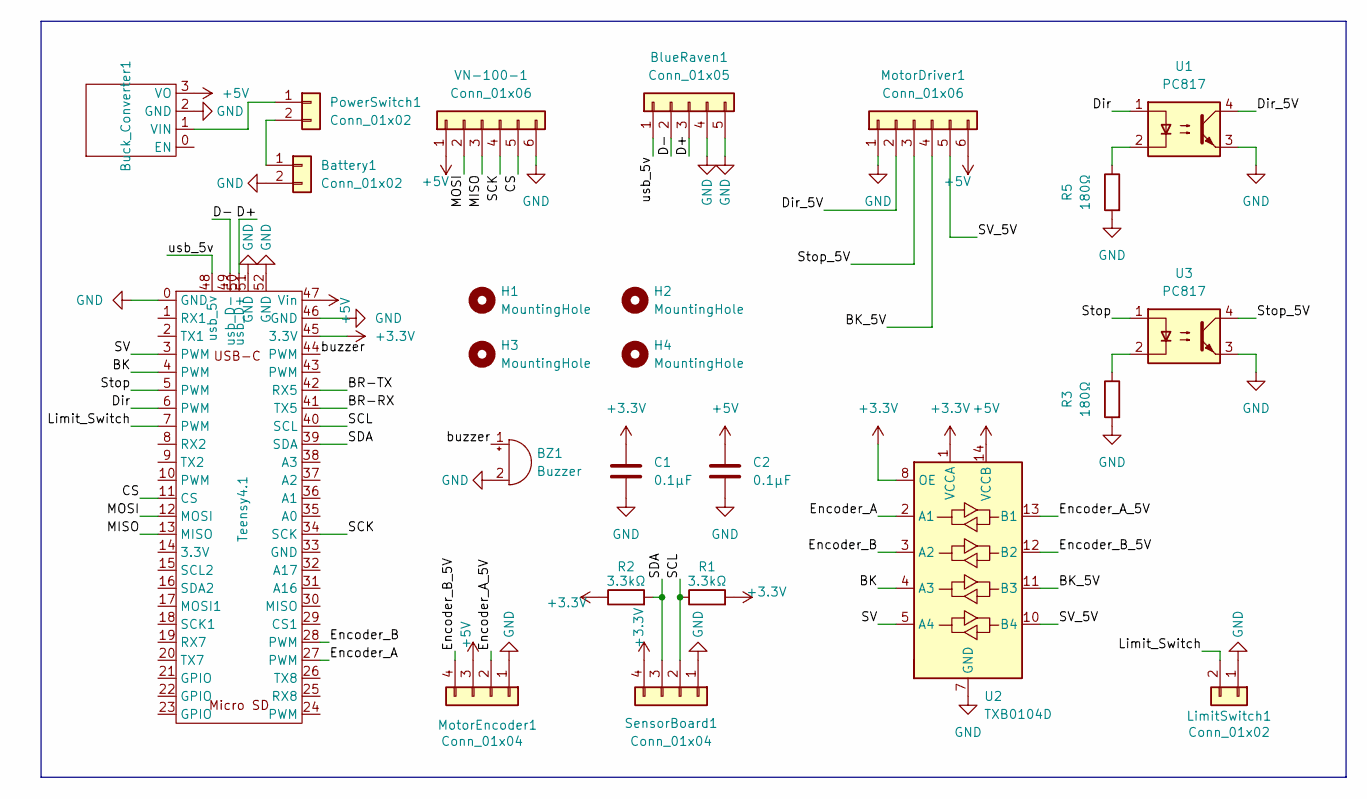
[picture p52: schematic Airbrake_ComputeBoard.kicad_sch]

Parts:
BZ1: Buzzer; Buzzer_12x9.5RM7.6
Battery1: Conn_01x02; JST_XH_B2B-XH-A_1x02_P2.50mm_Vertical
BlueRaven1: Conn_01x05; JST_XH_B5B-XH-A_1x05_P2.50mm_Vertical
Buck_Converter1: Buck_Converter
C1, C2: 0.1µF; C_0805_2012Metric_Pad1.18x1.45mm_HandSolder
H1, H2, H3, H4: MountingHole; MountingHole_3.2mm_M3
LimitSwitch1: Conn_01x02; JST_XH_B2B-XH-A_1x02_P2.50mm_Vertical
MotorDriver1: Conn_01x06; JST_XH_B6B-XH-A_1x06_P2.50mm_Vertical
MotorEncoder1: Conn_01x04; JST_XH_B4B-XH-A_1x04_P2.50mm_Vertical
PowerSwitch1: Conn_01x02; JST_XH_B2B-XH-A_1x02_P2.50mm_Vertical
R1, R2: 3.3kΩ; R_0805_2012Metric_Pad1.20x1.40mm_HandSolder
R3, R5: 180Ω; R_0805_2012Metric_Pad1.20x1.40mm_HandSolder
SensorBoard1: Conn_01x04; JST_XH_B4B-XH-A_1x04_P2.50mm_Vertical
Teensy4.1: Teensy_4.1_USB
U1, U3: PC817; DIP-4_W7.62mm
U2: TXB0104D; SOIC-14_3.9x8.7mm_P1.27mm
VN-100-1: Conn_01x06; JST_XH_B6B-XH-A_1x06_P2.50mm_Vertical

Connections:
+3.3V: C1.1, R1.2, R2.1, SensorBoard1.4, Teensy4.1.45 (3.3V), U2.1 (VCCA), U2.8 (OE)
+5V: Buck_Converter1.3 (VO), C2.1, MotorDriver1.6, MotorEncoder1.3, Teensy4.1.47 (Vin), U2.14 (VCCB), VN-100-1.1
/BK: Teensy4.1.4 (PWM), U2.4 (A3)
/BK_5V: MotorDriver1.4, U2.11 (B3)
/BR-RX: Teensy4.1.41 (TX5)
/BR-TX: Teensy4.1.42 (RX5)
/CS: Teensy4.1.11 (CS), VN-100-1.5
/D+: BlueRaven1.3, Teensy4.1.50 (usb_D+)
/D-: BlueRaven1.2, Teensy4.1.49 (usb_D-)
/Dir: Teensy4.1.6 (PWM), U1.1
/Dir_5V: MotorDriver1.2, U1.4
/Encoder_A: Teensy4.1.27 (PWM), U2.2 (A1)
/Encoder_A_5V: MotorEncoder1.2, U2.13 (B1)
/Encoder_B: Teensy4.1.28 (PWM), U2.3 (A2)
/Encoder_B_5V: MotorEncoder1.4, U2.12 (B2)
/Limit_Switch: LimitSwitch1.2, Teensy4.1.7 (PWM)
/MISO: Teensy4.1.13 (MISO), VN-100-1.3
/MOSI: Teensy4.1.12 (MOSI), VN-100-1.2
/SCK: Teensy4.1.34 (SCK), VN-100-1.4
/SCL: R1.1, SensorBoard1.2, Teensy4.1.40 (SCL)
/SDA: R2.2, SensorBoard1.3, Teensy4.1.39 (SDA)
/SV: Teensy4.1.3 (PWM), U2.5 (A4)
/SV_5V: MotorDriver1.5, U2.10 (B4)
/Stop: Teensy4.1.5 (PWM), U3.1
/Stop_5V: MotorDriver1.3, U3.4
/buzzer: BZ1.1 (+), Teensy4.1.44 (PWM)
/usb_5v: BlueRaven1.1, Teensy4.1.48 (usb_5v)
GND: BZ1.2 (-), Battery1.2, BlueRaven1.4, BlueRaven1.5, Buck_Converter1.2 (GND), C1.2, C2.2, LimitSwitch1.1, MotorDriver1.1, MotorEncoder1.1, R3.2, R5.2, SensorBoard1.1, Teensy4.1.0 (GND), Teensy4.1.46 (GND), Teensy4.1.51 (GND), Teensy4.1.52 (GND), U1.3, U2.7 (GND), U3.3, VN-100-1.6
unnamed: Battery1.1, PowerSwitch1.2
unnamed: Buck_Converter1.1 (VIN), PowerSwitch1.1
unnamed: R3.1, U3.2
unnamed: R5.1, U1.2

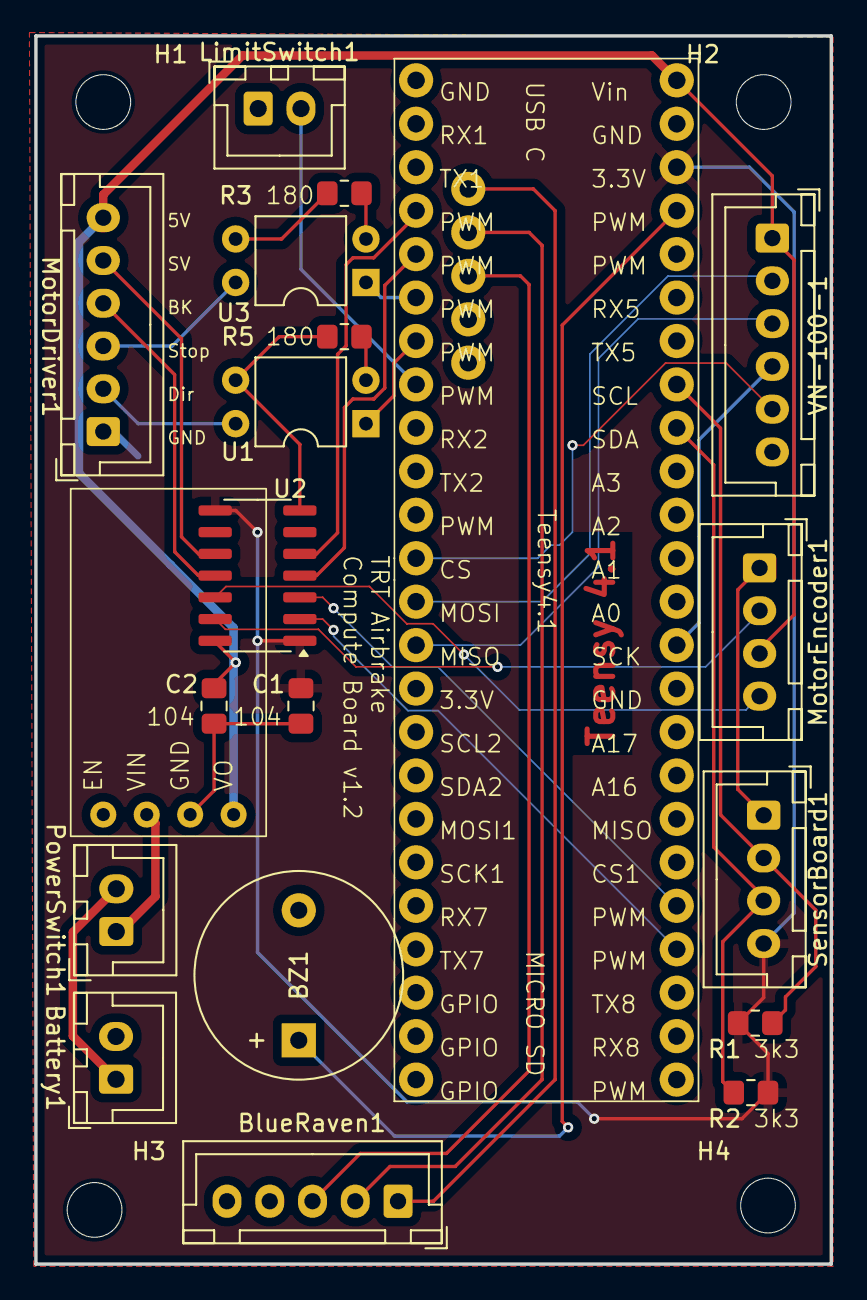
[picture p53: board Airbrake_ComputeBoard.kicad_pcb from above]

Board: 2 copper layers, 46.5 x 71.8 mm, 24 parts (0 on the bottom side), 30 nets.
