Terrapin-Rocket-Team/Airbrake/Flight_Code/src/AirbrakeKF.cpp

#include "AirbrakeKF.h"

// Define the measurement size, control size, and state size
AirbrakeKF::AirbrakeKF() : LinearKalmanFilter(3, 3, 6) {}

astra::Matrix AirbrakeKF::getF(double dt) {
    double *data = new double[36]{
        1.0, 0, 0, dt, 0, 0,
        0, 1.0, 0, 0, dt, 0,
        0, 0, 1.0, 0, 0, dt,
        0, 0, 0, 1.0, 0, 0,
        0, 0, 0, 0, 1.0, 0,
        0, 0, 0, 0, 0, 1.0
    };
    return astra::Matrix(6, 6, data);
}

astra::Matrix AirbrakeKF::getG(double dt) {
    double *data = new double[18]{
        0.5 * dt * dt, 0, 0,
        0, 0.5 * dt * dt, 0,
        0, 0, 0.5 * dt * dt,
        dt, 0, 0,
        0, dt, 0,
        0, 0, dt
    };
    return astra::Matrix(6, 3, data);
}

astra::Matrix AirbrakeKF::getH() {
    double *data = new double[18]{
        1.0, 0, 0, 0, 0, 0,
        0, 1.0, 0, 0, 0, 0,
        0, 0, 1.0, 0, 0, 0,
    };
    return astra::Matrix(3, 6, data);
}

astra::Matrix AirbrakeKF::getR() {
    double *data = new double[9]{
        gpsMAX_std, 0, 0,
        0, gpsMAX_std, 0,
        0, 0, dps310_std,
    };
    return astra::Matrix(3, 3, data);
}

astra::Matrix AirbrakeKF::getQ(double dt) {
    double *data = new double[36]{
        std::pow(dt, 4)/4, 0, 0, std::pow(dt, 3)/2, 0, 0,
        0, std::pow(dt, 4)/4, 0, 0, std::pow(dt, 3)/2, 0,
        0, 0, std::pow(dt, 4)/4, 0, 0, std::pow(dt, 3)/2,
        std::pow(dt, 3)/2, 0, 0, std::pow(dt, 2), 0, 0,
        0, std::pow(dt, 3)/2, 0, 0, std::pow(dt, 2), 0,
        0, 0, std::pow(dt, 3)/2, 0, 0, std::pow(dt, 2)
    };
    return astra::Matrix(6, 6, data)*processNoise*processNoise;
}
