Terrapin-Rocket-Team/Airbrake/Flight_Code/src/AirbrakeKF.h

#ifndef AIRBRAKE_KF_H
#define AIRBRAKE_KF_H

#include <Filters/LinearKalmanFilter.h>



class AirbrakeKF : public astra::LinearKalmanFilter {
public:
    AirbrakeKF();
    ~AirbrakeKF() = default;

    // Measurement noise
    double gpsMAX_std = 1; // [m]
    double dps310_std = .2; // [m]
    double ms5611_std = .5; // [m]
    
    double processNoise = .5; // [m]

    // Override getter methods to provide subteam-specific matrix implementations
    void initialize() override {};
    astra::Matrix getF(double dt) override;
    astra::Matrix getG(double dt) override;
    astra::Matrix getH() override;
    astra::Matrix getR() override;
    astra::Matrix getQ(double dt) override;
};


#endif // AIRBRAKE_KF_H
