Terrapin-Rocket-Team/Airbrake/Astra-Rocket/src/md6.h

#ifndef MD_H
#define MD_H
#include <ODriveUART.h>
#include <Arduino.h>
#include "Utils/CircBuffer.h"
#include "Sensors/Sensor.h"


enum StalledState{
    STOPPED,
    TOP,
    BOTTOM,
    MOVING,
    ERROR
};

namespace astra
{
    class MotorDriver : public Sensor
    {
    private:
        int motorstallcounter = 10;
        ODriveFeedback feedback;
        CircBuffer<float> positionHistory = CircBuffer<float>(motorstallcounter);
               

    protected:
        // Add protected members and methods specific to MD6 here
        float position = 0; // current position
        float angle = 0;
        float velocity = 0; // current velocity
        float initposition = 0; // position when zeroed
        float targetposition = 0; // target position
        float targetvelocity = 0; // target velocity
        float targetAngle = 0; // commanded flap angle (deg)
        float voltage = 0;

        int topLimitSwitchPin = 35;
        StalledState stalledstate = STOPPED;

#if defined(NATIVE)
        uint64_t lastNativeUpdateMicros = 0;
        bool nativeTimebaseReady = false;
        double lastNativeUpdateSimTime = 0.0;
        bool nativeSimTimebaseReady = false;
        bool nativeUsingSimClock = false;
        float nativeMaxPosPerSecond = 0;
        void updateNativeSimulation();
#endif
        

    public:
        MotorDriver(const char *name = "MotorDriver") : Sensor(name)
        {
            setName(name);
            addColumn("%0.3f", &position, "Motor Position");
            addColumn("%0.1f", &angle, "Motor Angle");
            addColumn("%0.1f", &targetAngle, "Motor Target Angle");
            addColumn("%0.3f", &velocity, "Motor Velocity");
            addColumn("%0.3f", &voltage, "Battery Voltage");
        }

        int init() override;
        int read() override;
        bool isInitialized() const { return initialized; }

        float getPosition();
        float getVelocity();
        float getTargetPosition() const { return targetposition; }
        float getTargetAngle() const { return targetAngle; }
        float angleToPos(float angle);
        float posToAngle(float pos);

        void setPos(float pos);
        void setVel(float vel);

        bool zeroMotor();
        bool motorStall();
    };
}


#endif // MD_H
