Terrapin-Rocket-Team/Airbrake/Astra-Rocket/desktop_simulation.py

#!/usr/bin/env python3
"""
Desktop HITL Simulation for Astra-Rocket

This script simulates a rocket flight and sends sensor data to the
flight computer over USB Serial at a controlled rate. The FC processes the data
and sends back TELEM/ packets at its configured logging rate.

Supports three modes:
    1. OpenRocket CSV mode: Load data from an OpenRocket CSV export file
    2. Flight Data CSV mode: Load real sensor data from previous flight recordings
    3. Physics mode: Generate data from simple physics simulation

The script automatically detects the CSV type based on column headers:
    - Flight data CSVs contain sensor names (BMI088, DPS310, etc.) and raw sensor readings
    - OpenRocket CSVs contain simulation outputs (Vertical acceleration, Altitude (ft), etc.)

Protocol:
    1. Sim sends HITL/ packet at simulation rate (50Hz)
    2. FC processes and updates state
    3. FC sends TELEM/ at logging rate (configured in FC, typically 10-50Hz)
    4. Sim reads and logs all TELEM/ responses asynchronously

The sim paces itself to avoid overwhelming the FC's serial buffer while maintaining
accurate simulation timing.

Requirements:
    pip install pyserial numpy matplotlib

Usage:
    python desktop_simulation.py /dev/ttyACM0 [csv_file]  # Linux/Mac
    python desktop_simulation.py COM3 [csv_file]          # Windows

    If csv_file is provided, uses CSV data (auto-detects type). Otherwise uses physics simulation.
"""

import serial
import time
import sys
import csv
import numpy as np
import matplotlib.pyplot as plt
from matplotlib.animation import FuncAnimation
from dataclasses import dataclass, field
from typing import Tuple, List, Optional, Dict
import math
import threading

@dataclass
class SimState:
    """Simulation state variables"""
    time: float = 0.0
    position: np.ndarray = field(default_factory=lambda: np.array([0.0, 0.0, 0.0]))  # [x, y, z] in meters
    velocity: np.ndarray = field(default_factory=lambda: np.array([0.0, 0.0, 0.0]))  # [vx, vy, vz] in m/s
    orientation: np.ndarray = field(default_factory=lambda: np.array([0.0, 0.0, 0.0]))  # [roll, pitch, yaw] in radians
    ang_velocity: np.ndarray = field(default_factory=lambda: np.array([0.0, 0.0, 0.0]))  # [wx, wy, wz] in rad/s


class FlightDataSimulation:
    """Rocket simulation from old flight data CSV (actual sensor data from previous flights)"""

    def __init__(self, csv_file: str, dt=0.02, ignition_delay=2.0):
        """
        Load flight data CSV file and prepare for playback

        Args:
            csv_file: Path to flight data CSV export
            dt: Desired timestep for playback (will interpolate data)
            ignition_delay: Time to hold at first data point before starting playback
        """
        self.dt = dt
        self.g = 9.81  # Gravity (m/s^2)
        self.state = SimState()
        self.ignition_delay = ignition_delay

        # Load CSV data
        self.data = self._load_csv(csv_file)
        self.current_index = 0
        self.max_index = len(self.data['time']) - 1

        print(f"Loaded flight data CSV with {len(self.data['time'])} data points")
        print(f"Flight duration: {self.data['time'][-1]:.2f} seconds")
        if self.data['altitude']:
            print(f"Max altitude: {max(self.data['altitude']):.2f} m")
        print(f"First row - Time: {self.data['time'][0]:.3f}s")

    def _load_csv(self, csv_file: str) -> Dict[str, List[float]]:
        """Load and parse flight data CSV file"""
        data = {
            'time': [],
            'altitude': [],
            'velocity': [],
            'accel_x': [],
            'accel_y': [],
            'accel_z': [],
            'gyro_x': [],
            'gyro_y': [],
            'gyro_z': [],
            'mag_x': [],
            'mag_y': [],
            'mag_z': [],
            'pressure': [],
            'temperature': [],
            'lat': [],
            'lon': [],
            'gps_alt': []
        }

        with open(csv_file, 'r') as f:
            reader = csv.reader(f)
            header = next(reader)

            # Strip whitespace from headers
            header = [h.strip() for h in header]

            # Helper function to find column index (case-insensitive, flexible matching)
            def find_col(*keywords):
                for kw in keywords:
                    for i, h in enumerate(header):
                        if kw.lower() in h.lower():
                            return i
                return None

            # Find time column
            col_time = find_col('state - time (s)', 'time (s)')

            # Find ANY accelerometer columns (excluding State columns)
            col_accel_x = None
            col_accel_y = None
            col_accel_z = None
            for i, h in enumerate(header):
                h_lower = h.lower()
                if 'state' not in h_lower:  # Skip State columns
                    if 'accx' in h_lower or 'acc x' in h_lower:
                        col_accel_x = i
                        print(f"Found accelerometer X: '{header[i]}'")
                    elif 'accy' in h_lower or 'acc y' in h_lower:
                        col_accel_y = i
                        print(f"Found accelerometer Y: '{header[i]}'")
                    elif 'accz' in h_lower or 'acc z' in h_lower:
                        col_accel_z = i
                        print(f"Found accelerometer Z: '{header[i]}'")

            # Find ANY gyro columns (excluding State columns)
            col_gyro_x = None
            col_gyro_y = None
            col_gyro_z = None
            for i, h in enumerate(header):
                h_lower = h.lower()
                if 'state' not in h_lower:  # Skip State columns
                    if 'gyrox' in h_lower or 'gyro x' in h_lower:
                        col_gyro_x = i
                        print(f"Found gyroscope X: '{header[i]}'")
                    elif 'gyroy' in h_lower or 'gyro y' in h_lower:
                        col_gyro_y = i
                        print(f"Found gyroscope Y: '{header[i]}'")
                    elif 'gyroz' in h_lower or 'gyro z' in h_lower:
                        col_gyro_z = i
                        print(f"Found gyroscope Z: '{header[i]}'")

            # Find ANY magnetometer columns (excluding State columns)
            col_mag_x = None
            col_mag_y = None
            col_mag_z = None
            for i, h in enumerate(header):
                h_lower = h.lower()
                if 'state' not in h_lower:  # Skip State columns
                    if 'magx' in h_lower or 'mag x' in h_lower:
                        col_mag_x = i
                        print(f"Found magnetometer X: '{header[i]}'")
                    elif 'magy' in h_lower or 'mag y' in h_lower:
                        col_mag_y = i
                        print(f"Found magnetometer Y: '{header[i]}'")
                    elif 'magz' in h_lower or 'mag z' in h_lower:
                        col_mag_z = i
                        print(f"Found magnetometer Z: '{header[i]}'")

            # Find barometer columns (look for any barometer sensor)
            col_pressure = find_col('pres (hpa)', 'pressure')
            col_temp = find_col('temp (c)', 'temperature')

            # Find GPS columns
            col_lat = find_col('lat', 'latitude')
            col_lon = find_col('lon', 'longitude')
            col_gps_alt = find_col('alt (m)', 'altitude')

            # Find altitude columns (State PZ or GPS alt)
            col_alt = find_col('state - pz (m)')
            if col_alt is None:
                col_alt = col_gps_alt

            # Find velocity columns
            col_vel_z = find_col('state - vz (m/s)')

            # Read data rows
            first_time = None
            for row in reader:
                try:
                    # Time (required) - normalize to start from 0
                    if col_time is not None:
                        raw_time = float(row[col_time])
                        if first_time is None:
                            first_time = raw_time
                        data['time'].append(raw_time - first_time)  # Offset to start at 0

                    # Altitude (from State PZ or GPS)
                    if col_alt is not None:
                        data['altitude'].append(float(row[col_alt]))
                    else:
                        data['altitude'].append(0.0)

                    # Velocity Z
                    if col_vel_z is not None:
                        data['velocity'].append(float(row[col_vel_z]))
                    else:
                        data['velocity'].append(0.0)

                    # Accelerometer (m/s^2)
                    if col_accel_x is not None:
                        data['accel_x'].append(float(row[col_accel_x]))
                    else:
                        data['accel_x'].append(0.0)

                    if col_accel_y is not None:
                        data['accel_y'].append(float(row[col_accel_y]))
                    else:
                        data['accel_y'].append(0.0)

                    if col_accel_z is not None:
                        data['accel_z'].append(float(row[col_accel_z]))
                    else:
                        data['accel_z'].append(self.g)  # Default to 1g upward

                    # Gyroscope (rad/s)
                    if col_gyro_x is not None:
                        data['gyro_x'].append(float(row[col_gyro_x]))
                    else:
                        data['gyro_x'].append(0.0)

                    if col_gyro_y is not None:
                        data['gyro_y'].append(float(row[col_gyro_y]))
                    else:
                        data['gyro_y'].append(0.0)

                    if col_gyro_z is not None:
                        data['gyro_z'].append(float(row[col_gyro_z]))
                    else:
                        data['gyro_z'].append(0.0)

                    # Magnetometer (uT - will convert to standard units later if needed)
                    if col_mag_x is not None:
                        data['mag_x'].append(float(row[col_mag_x]))
                    else:
                        data['mag_x'].append(20.0)

                    if col_mag_y is not None:
                        data['mag_y'].append(float(row[col_mag_y]))
                    else:
                        data['mag_y'].append(10.0)

                    if col_mag_z is not None:
                        data['mag_z'].append(float(row[col_mag_z]))
                    else:
                        data['mag_z'].append(-45.0)

                    # Barometer
                    if col_pressure is not None:
                        data['pressure'].append(float(row[col_pressure]))
                    else:
                        data['pressure'].append(1013.25)

                    if col_temp is not None:
                        data['temperature'].append(float(row[col_temp]))
                    else:
                        data['temperature'].append(25.0)

                    # GPS
                    if col_lat is not None:
                        data['lat'].append(float(row[col_lat]))
                    else:
                        data['lat'].append(45.0)

                    if col_lon is not None:
                        data['lon'].append(float(row[col_lon]))
                    else:
                        data['lon'].append(-122.0)

                    if col_gps_alt is not None:
                        data['gps_alt'].append(float(row[col_gps_alt]))
                    else:
                        data['gps_alt'].append(0.0)

                except (ValueError, IndexError):
                    # Skip malformed rows
                    continue

        return data

    def step(self) -> SimState:
        """Get next timestep of data (interpolates between CSV rows if needed)"""
        # Update simulation time
        self.state.time += self.dt

        # If still in ignition delay, hold at first data point
        if self.state.time < self.ignition_delay:
            idx = 0
            self.state.position[0] = 0.0
            self.state.position[1] = 0.0
            self.state.position[2] = self.data['altitude'][idx] if self.data['altitude'] else 0.0
            self.state.velocity[0] = 0.0
            self.state.velocity[1] = 0.0
            self.state.velocity[2] = 0.0
            self.state.ang_velocity[0] = 0.0
            self.state.ang_velocity[1] = 0.0
            self.state.ang_velocity[2] = 0.0
            return self.state

        # After ignition delay, use CSV data
        # Adjust target time to account for ignition delay
        csv_time = self.state.time - self.ignition_delay

        # Find the two data points to interpolate between
        while self.current_index < self.max_index and self.data['time'][self.current_index + 1] < csv_time:
            self.current_index += 1

        # Clamp to valid range
        if self.current_index >= self.max_index:
            self.current_index = self.max_index
            idx = self.current_index
            alpha = 0.0
        else:
            idx = self.current_index
            t0 = self.data['time'][idx]
            t1 = self.data['time'][idx + 1]
            alpha = (csv_time - t0) / (t1 - t0) if t1 > t0 else 0.0

        # Linear interpolation helper
        def lerp(key):
            if alpha == 0.0 or idx >= self.max_index:
                return self.data[key][idx]
            return self.data[key][idx] * (1 - alpha) + self.data[key][idx + 1] * alpha

        # Position (assume stationary in X/Y)
        self.state.position[0] = 0.0
        self.state.position[1] = 0.0
        self.state.position[2] = lerp('altitude')

        # Velocity (only have vertical)
        self.state.velocity[0] = 0.0
        self.state.velocity[1] = 0.0
        self.state.velocity[2] = lerp('velocity')

        # Angular velocity (from gyro)
        self.state.ang_velocity[0] = lerp('gyro_x')
        self.state.ang_velocity[1] = lerp('gyro_y')
        self.state.ang_velocity[2] = lerp('gyro_z')

        return self.state

    def get_sensor_data(self, state: SimState) -> dict:
        """Convert state to sensor readings"""
        # During ignition delay, use first data point
        if state.time < self.ignition_delay:
            idx = 0
        else:
            idx = min(self.current_index, self.max_index)

        # Use actual sensor data from CSV (already in m/s^2 for accelerometer)
        accel_body = np.array([
            self.data['accel_x'][idx],
            self.data['accel_y'][idx],
            self.data['accel_z'][idx]
        ])

        # Magnetometer data (convert from uT to uT, no conversion needed)
        mag_body = np.array([
            self.data['mag_x'][idx],
            self.data['mag_y'][idx],
            self.data['mag_z'][idx]
        ])

        return {
            'timestamp': state.time,
            'accel': accel_body,
            'gyro': state.ang_velocity,
            'mag': mag_body,
            'pressure': self.data['pressure'][idx],
            'temperature': self.data['temperature'][idx],
            'gps_lat': self.data['lat'][idx],
            'gps_lon': self.data['lon'][idx],
            'gps_alt': self.data['gps_alt'][idx],
            'gps_fix': 1 if state.time > 1.0 else 0,
            'gps_fix_quality': 8 if state.time > 1.0 else 0,
            'gps_heading': 0.0
        }


class CSVSimulation:
    """Rocket simulation from OpenRocket CSV export"""

    def __init__(self, csv_file: str, dt=0.02, ignition_delay=2.0):
        """
        Load OpenRocket CSV file and prepare for playback

        Args:
            csv_file: Path to OpenRocket CSV export
            dt: Desired timestep for playback (will interpolate data)
            ignition_delay: Time to hold at first data point before starting playback
        """
        self.dt = dt
        self.g = 9.81  # Gravity (m/s^2)
        self.state = SimState()
        self.ignition_delay = ignition_delay

        # Load CSV data
        self.data = self._load_csv(csv_file)
        self.current_index = 0
        self.max_index = len(self.data['time']) - 1

        print(f"Loaded CSV with {len(self.data['time'])} data points")
        print(f"Flight duration: {self.data['time'][-1]:.2f} seconds")
        print(f"Max altitude: {max(self.data['altitude']):.2f} m")
        print(f"First row - Time: {self.data['time'][0]:.3f}s, Alt: {self.data['altitude'][0]:.2f}m, Accel: {self.data['acceleration'][0]:.2f} m/s²")
        print(f"Calculated accel for first packet: {self.data['acceleration'][0] + self.g:.2f} m/s² (should be ~9.81 on pad)")

    def _load_csv(self, csv_file: str) -> Dict[str, List[float]]:
        """Load and parse OpenRocket CSV file"""
        data = {
            'time': [],
            'altitude': [],
            'velocity': [],
            'acceleration': [],
            'pressure': [],
            'temperature': [],
            'lat': [],
            'lon': [],
            'roll_rate': [],
            'pitch_rate': [],
            'yaw_rate': [],
            'pos_east': [],
            'pos_north': []
        }

        with open(csv_file, 'r') as f:
            reader = csv.reader(f)
            header = next(reader)

            # Find column indices (case-insensitive, flexible matching)
            header_lower = [h.strip().lower() for h in header]

            # Helper function to find column index
            def find_col(*keywords):
                for kw in keywords:
                    for i, h in enumerate(header_lower):
                        if kw in h:
                            return i
                return None

            col_time = find_col('time (s)', 'time(s)')
            col_alt = find_col('altitude (ft)', 'altitude(ft)', 'altitude above sea level')
            col_vel = find_col('vertical velocity (m/s)', 'vertical velocity(m/s)')

            # Be very specific about vertical acceleration to avoid matching "Total acceleration"
            col_accel = None
            col_accel_name = None
            for i, h in enumerate(header_lower):
                if 'vertical acceleration' in h and 'total' not in h:
                    col_accel = i
                    col_accel_name = header[i]  # Store original header name for debugging
                    break

            # Debug output to show which column was matched
            if col_accel is not None:
                print(f"DEBUG: Matched acceleration column: '{col_accel_name}' (index {col_accel})")
            else:
                print(f"WARNING: No acceleration column found!")

            col_pressure = find_col('air pressure (mbar)', 'air pressure(mbar)', 'pressure')
            col_temp = find_col('air temperature (°f)', 'air temperature(°f)', 'temperature')
            col_lat = find_col('latitude (° n)', 'latitude(° n)', 'latitude')
            col_lon = find_col('longitude (° e)', 'longitude(° e)', 'longitude')
            col_roll = find_col('roll rate (r/s)', 'roll rate(r/s)')
            col_pitch = find_col('pitch rate (r/s)', 'pitch rate(r/s)')
            col_yaw = find_col('yaw rate (r/s)', 'yaw rate(r/s)')
            col_east = find_col('position east of launch (ft)', 'position east')
            col_north = find_col('position north of launch (ft)', 'position north')

            # Read data rows
            for row in reader:
                try:
                    # Time (required)
                    if col_time is not None:
                        data['time'].append(float(row[col_time]))

                    # Altitude in feet -> convert to meters
                    if col_alt is not None:
                        alt_ft = float(row[col_alt])
                        data['altitude'].append(alt_ft * 0.3048)
                    else:
                        data['altitude'].append(0.0)

                    # Vertical velocity (already in m/s)
                    if col_vel is not None:
                        data['velocity'].append(float(row[col_vel]))
                    else:
                        data['velocity'].append(0.0)

                    # Vertical acceleration (already in m/s²)
                    if col_accel is not None:
                        data['acceleration'].append(float(row[col_accel]))
                    else:
                        data['acceleration'].append(0.0)

                    # Pressure (mbar = hPa, no conversion needed)
                    if col_pressure is not None:
                        data['pressure'].append(float(row[col_pressure]))
                    else:
                        data['pressure'].append(1013.25)

                    # Temperature °F -> °C
                    if col_temp is not None:
                        temp_f = float(row[col_temp])
                        data['temperature'].append((temp_f - 32) * 5/9)
                    else:
                        data['temperature'].append(25.0)

                    # GPS coordinates
                    if col_lat is not None:
                        data['lat'].append(float(row[col_lat]))
                    else:
                        data['lat'].append(45.0)

                    if col_lon is not None:
                        data['lon'].append(float(row[col_lon]))
                    else:
                        data['lon'].append(-122.0)

                    # Angular rates (r/s -> rad/s), replace NaN with 0
                    if col_roll is not None:
                        try:
                            roll_val = float(row[col_roll])
                            data['roll_rate'].append(0.0 if math.isnan(roll_val) else roll_val * 2 * math.pi)
                        except ValueError:
                            data['roll_rate'].append(0.0)
                    else:
                        data['roll_rate'].append(0.0)

                    if col_pitch is not None:
                        try:
                            pitch_val = float(row[col_pitch])
                            data['pitch_rate'].append(0.0 if math.isnan(pitch_val) else pitch_val * 2 * math.pi)
                        except ValueError:
                            data['pitch_rate'].append(0.0)
                    else:
                        data['pitch_rate'].append(0.0)

                    if col_yaw is not None:
                        try:
                            yaw_val = float(row[col_yaw])
                            data['yaw_rate'].append(0.0 if math.isnan(yaw_val) else yaw_val * 2 * math.pi)
                        except ValueError:
                            data['yaw_rate'].append(0.0)
                    else:
                        data['yaw_rate'].append(0.0)

                    # Position offsets (feet -> meters)
                    if col_east is not None:
                        data['pos_east'].append(float(row[col_east]) * 0.3048)
                    else:
                        data['pos_east'].append(0.0)

                    if col_north is not None:
                        data['pos_north'].append(float(row[col_north]) * 0.3048)
                    else:
                        data['pos_north'].append(0.0)

                except (ValueError, IndexError):
                    # Skip malformed rows
                    continue

        # OpenRocket CSVs often start at T>0 (e.g., T=0.01s) with motor already firing
        # Add a synthetic T=0.0s row at pad conditions if needed
        if len(data['time']) > 0 and data['time'][0] > 0.0:
            print(f"INFO: CSV starts at T={data['time'][0]:.3f}s, adding synthetic T=0.000s pad row")
            # Insert pad conditions at T=0.0
            data['time'].insert(0, 0.0)
            data['altitude'].insert(0, 0.0)
            data['velocity'].insert(0, 0.0)
            data['acceleration'].insert(0, 0.0)  # On pad, kinematic accel = 0
            data['pressure'].insert(0, data['pressure'][0] if len(data['pressure']) > 0 else 1013.25)
            data['temperature'].insert(0, data['temperature'][0] if len(data['temperature']) > 0 else 25.0)
            data['lat'].insert(0, data['lat'][0] if len(data['lat']) > 0 else 45.0)
            data['lon'].insert(0, data['lon'][0] if len(data['lon']) > 0 else -122.0)
            data['roll_rate'].insert(0, 0.0)
            data['pitch_rate'].insert(0, 0.0)
            data['yaw_rate'].insert(0, 0.0)
            data['pos_east'].insert(0, 0.0)
            data['pos_north'].insert(0, 0.0)

        return data

    def step(self) -> SimState:
        """Get next timestep of data (interpolates between CSV rows if needed)"""
        # Update simulation time
        self.state.time += self.dt

        # If still in ignition delay, hold at first data point
        if self.state.time < self.ignition_delay:
            idx = 0
            self.state.position[0] = self.data['pos_east'][idx]
            self.state.position[1] = self.data['pos_north'][idx]
            self.state.position[2] = self.data['altitude'][idx]
            self.state.velocity[0] = 0.0
            self.state.velocity[1] = 0.0
            self.state.velocity[2] = 0.0
            self.state.ang_velocity[0] = 0.0
            self.state.ang_velocity[1] = 0.0
            self.state.ang_velocity[2] = 0.0
            return self.state

        # After ignition delay, use CSV data
        # Adjust target time to account for ignition delay
        csv_time = self.state.time - self.ignition_delay

        # Find the two data points to interpolate between
        while self.current_index < self.max_index and self.data['time'][self.current_index + 1] < csv_time:
            self.current_index += 1

        # Clamp to valid range
        if self.current_index >= self.max_index:
            self.current_index = self.max_index
            idx = self.current_index
            alpha = 0.0
        else:
            idx = self.current_index
            t0 = self.data['time'][idx]
            t1 = self.data['time'][idx + 1]
            alpha = (csv_time - t0) / (t1 - t0) if t1 > t0 else 0.0

        # Linear interpolation helper
        def lerp(key):
            if alpha == 0.0 or idx >= self.max_index:
                return self.data[key][idx]
            return self.data[key][idx] * (1 - alpha) + self.data[key][idx + 1] * alpha

        # Position
        self.state.position[0] = lerp('pos_east')
        self.state.position[1] = lerp('pos_north')
        self.state.position[2] = lerp('altitude')

        # Velocity (only have vertical)
        self.state.velocity[0] = 0.0
        self.state.velocity[1] = 0.0
        self.state.velocity[2] = lerp('velocity')

        # Angular velocity
        self.state.ang_velocity[0] = lerp('roll_rate')
        self.state.ang_velocity[1] = lerp('pitch_rate')
        self.state.ang_velocity[2] = lerp('yaw_rate')

        return self.state

    def get_sensor_data(self, state: SimState) -> dict:
        """Convert state to sensor readings"""
        # During ignition delay, use first data point
        if state.time < self.ignition_delay:
            idx = 0
        else:
            idx = min(self.current_index, self.max_index)

        # Accelerometer reads specific force (not including gravity)
        # OpenRocket's acceleration does NOT include gravity (it's kinematic acceleration)
        # So when sitting on pad: OR shows 0 m/s², but accelerometer should read +g (support force)
        # Specific force = kinematic accel + gravity
        accel_z = self.data['acceleration'][idx] + self.g

        # For X and Y, we don't have data from OpenRocket, so use 0
        # In ENU frame: X=East, Y=North, Z=Up
        accel_body = np.array([0.0, 0.0, accel_z])

        return {
            'timestamp': state.time,
            'accel': accel_body,  # ENU frame (X=East, Y=North, Z=Up)
            'gyro': state.ang_velocity,  # [roll, pitch, yaw] rates in rad/s
            'mag': np.array([20.0, 10.0, -45.0]),  # Constant magnetic field
            'pressure': self.data['pressure'][idx],
            'temperature': self.data['temperature'][idx],
            'gps_lat': self.data['lat'][idx],
            'gps_lon': self.data['lon'][idx],
            'gps_alt': state.position[2],
            'gps_fix': 1 if state.time > 1.0 else 0,  # GPS fix after 1 second
            'gps_fix_quality': 8 if state.time > 1.0 else 0,
            'gps_heading': 0.0
        }

class RocketSimulation:
    """Simple 3DOF rocket flight simulation"""

    def __init__(self, dt=0.02, ignition_delay=3.0):
        self.dt = dt  # Timestep (50 Hz)
        self.state = SimState()
        self.g = 9.81  # Gravity (m/s^2)

        # Ignition delay - time to wait before motor ignites
        self.ignition_delay = ignition_delay

        # Rocket parameters (typical high-power rocket)
        self.mass = 5.0  # kg (11 lbs)
        self.motor_thrust = 3000.0  # N (typical I-motor produces ~300N average)
        self.motor_burnout = 1.0  # seconds
        self.drag_coeff = 0.02  # N/(m/s)^2 (more realistic for streamlined rocket)

    def compute_forces(self, state: SimState) -> Tuple[np.ndarray, np.ndarray]:
        """Compute forces and torques on rocket"""
        # Thrust (only after ignition delay and during motor burn)
        time_since_ignition = state.time - self.ignition_delay

        if 0 <= time_since_ignition < self.motor_burnout:
            thrust = np.array([0, 0, self.motor_thrust])
        else:
            thrust = np.array([0, 0, 0])

        # Gravity
        gravity = np.array([0, 0, -self.mass * self.g])

        # Drag (simplified)
        v_mag = np.linalg.norm(state.velocity)
        if v_mag > 0:
            drag = -self.drag_coeff * v_mag**2 * (state.velocity / v_mag)
        else:
            drag = np.array([0, 0, 0])

        # Total force
        force = thrust + gravity + drag

        # No torques in this simple sim
        torque = np.array([0, 0, 0])

        return force, torque

    def step(self) -> SimState:
        """Advance simulation by one timestep"""
        # Compute forces
        force, torque = self.compute_forces(self.state)

        # Update velocity and position (Euler integration)
        acceleration = force / self.mass
        self.state.velocity += acceleration * self.dt
        self.state.position += self.state.velocity * self.dt

        # Ground contact (prevents falling through floor during ignition delay)
        if self.state.position[2] < 0:
            self.state.position[2] = 0
            # Only zero out velocity if falling down
            if self.state.velocity[2] < 0:
                self.state.velocity[2] = 0

        # Update time
        self.state.time += self.dt

        return self.state

    def get_sensor_data(self, state: SimState) -> dict:
        """Convert state to sensor readings"""
        # Accelerometers measure specific force (all forces EXCEPT gravity)
        # On the pad, they read +1g upward. In free fall, they read 0.
        force, _ = self.compute_forces(state)
        # Remove gravity from total force to get specific force
        specific_force = force - np.array([0, 0, -self.mass * self.g])
        accel_body = specific_force / self.mass

        # IMPORTANT: Mahony filter expects ENU frame (X=East, Y=North, Z=Up)
        # Our simulation is already in ENU, so no transformation needed
        # Just use accel_body directly

        # Pressure from altitude (barometric formula)
        # Calculate in Pa, then convert to hPa for the flight computer
        pressure_pa = 101325.0 * (1 - 0.0065 * state.position[2] / 288.15)**5.255
        pressure = pressure_pa / 100.0  # Convert Pa to hPa

        # GPS position (lat, lon, alt)
        # Assume launch site at 45.0°N, 122.0°W
        lat = 45.0 + (state.position[0] / 111320.0)  # 1 degree lat ≈ 111.32 km
        lon = -122.0 + (state.position[1] / (111320.0 * np.cos(np.radians(45.0))))
        alt = state.position[2]

        return {
            'timestamp': state.time,
            'accel': accel_body,  # ENU frame (X=East, Y=North, Z=Up)
            'gyro': state.ang_velocity,
            'mag': np.array([20.0, 10.0, -45.0]),  # Constant magnetic field
            'pressure': pressure,
            'temperature': 25.0,  # Constant temp
            'gps_lat': lat,
            'gps_lon': lon,
            'gps_alt': alt,
            'gps_fix': 1 if state.time > 1.0 else 0,  # GPS fix after 1 second
            'gps_fix_quality': 8 if state.time > 1.0 else 0,
            'gps_heading': 0.0
        }

def format_hitl_packet(sensor_data: dict) -> str:
    """Format sensor data as HITL protocol message"""
    return (f"HITL/{sensor_data['timestamp']:.3f},"
            f"{sensor_data['accel'][0]:.6f},{sensor_data['accel'][1]:.6f},{sensor_data['accel'][2]:.6f},"
            f"{sensor_data['gyro'][0]:.6f},{sensor_data['gyro'][1]:.6f},{sensor_data['gyro'][2]:.6f},"
            f"{sensor_data['mag'][0]:.3f},{sensor_data['mag'][1]:.3f},{sensor_data['mag'][2]:.3f},"
            f"{sensor_data['pressure']:.2f},{sensor_data['temperature']:.2f},"
            f"{sensor_data['gps_lat']:.8f},{sensor_data['gps_lon']:.8f},{sensor_data['gps_alt']:.2f},"
            f"{sensor_data['gps_fix']},{sensor_data['gps_fix_quality']},{sensor_data['gps_heading']:.2f}\n")

def parse_telem_line(line: str, column_map: Optional[Dict[str, int]] = None) -> dict:
    """Parse TELEM/ line from flight computer"""
    # Simple parsing - you can extend this to extract specific fields
    if not line.startswith("TELEM/"):
        return {}

    # Strip prefix and split by comma
    data_str = line[6:].strip()
    values = data_str.split(',')

    result = {
        'raw': data_str,
        'values': values
    }

    # If we have a column map, extract specific fields
    if column_map:
        result['fields'] = {}
        for field_name, col_idx in column_map.items():
            if col_idx < len(values):
                result['fields'][field_name] = values[col_idx]

    return result

def parse_telem_header(header_line: str) -> dict:
    """Parse TELEM/ header line to create column mapping"""
    if not header_line.startswith("TELEM/"):
        return {}

    # Strip prefix and split by comma
    header_str = header_line[6:].strip()
    columns = header_str.split(',')

    # Create a mapping of interesting column names to their indices
    column_map = {}
    for idx, col_name in enumerate(columns):
        column_map[col_name.strip()] = idx

    return column_map

def main():
    if len(sys.argv) < 2:
        print("Usage: python desktop_simulation.py <serial_port> [csv_file] [--live-plot]")
        print("Example: python desktop_simulation.py /dev/ttyACM0")
        print("         python desktop_simulation.py COM3 FMMORK.csv")
        print("         python desktop_simulation.py COM3 FMMORK.csv --live-plot")
        sys.exit(1)

    port = sys.argv[1]
    csv_file = None
    live_plot = False

    # Parse arguments
    for arg in sys.argv[2:]:
        if arg == '--live-plot':
            live_plot = True
        elif not arg.startswith('--'):
            csv_file = arg

    baud = 115200

    print("===========================================")
    print("  Astra-Rocket HITL Desktop Simulation")
    print("===========================================")

    if csv_file:
        print(f"Mode: CSV playback from '{csv_file}'")
    else:
        print(f"Mode: Physics simulation")

    if live_plot:
        print(f"Live Plot: ENABLED")

    print(f"Connecting to {port} at {baud} baud...")

    # Connect to flight computer with retry
    ser = None
    max_retries = 30  # Try for 30 seconds
    retry_delay = 1.0

    for attempt in range(max_retries):
        try:
            ser = serial.Serial(port, baud, timeout=1.0)
            time.sleep(2)  # Wait for connection to stabilize
            print(f"Connected on attempt {attempt + 1}!")
            break
        except serial.SerialException as e:
            if attempt == 0:
                print(f"Connection failed, retrying... ({e})")
            elif (attempt + 1) % 5 == 0:
                print(f"  Still trying... (attempt {attempt + 1}/{max_retries})")
            time.sleep(retry_delay)

    if ser is None:
        print(f"\nERROR: Could not connect to {port} after {max_retries} attempts")
        print("\nMake sure:")
        print("  1. Flight computer is connected via USB")
        print("  2. Correct port is specified")
        print("  3. No other program is using the port")
        sys.exit(1)

    # Column mapping from header (will be populated when we receive header)
    column_map: Optional[Dict[str, int]] = None
    header_columns: Optional[List[str]] = None

    # Request header from FC using CMD/HEADER
    print("Requesting telemetry header from FC...")
    ser.write(b"CMD/HEADER\n")
    ser.flush()

    # Wait for header response (with timeout)
    header_timeout = time.time() + 5.0  # 5 second timeout
    header_received = False

    while time.time() < header_timeout and not header_received:
        if ser.in_waiting:
            line = ser.readline().decode('utf-8', errors='ignore').strip()
            # Check if this is the telemetry header
            if line.startswith("TELEM/") and ('State - Time (s)' in line or 'State - Flight Stage' in line):
                column_map = parse_telem_header(line)
                header_columns = line[6:].strip().split(',')  # Save header for CSV
                print(f"[FC] [HEADER] Received and parsed telemetry header with {len(column_map)} columns")
                header_received = True
            else:
                if line:  # Only print non-empty lines
                    print(f"[FC] {line}")
        else:
            time.sleep(0.01)  # Small delay to avoid busy waiting

    if not header_received:
        print("WARNING: Did not receive header from FC within timeout. Will try to parse from telemetry stream.")

    # Clear any remaining startup messages
    time.sleep(0.1)
    while ser.in_waiting:
        line = ser.readline().decode('utf-8', errors='ignore').strip()
        if line:
            print(f"[FC] {line}")

    print("\nStarting simulation...")
    print("-" * 60)

    # Simulation parameters
    dt = 0.02  # 50 Hz
    warmup_time = 1.0  # Hold at ground level for 1 second to let KF settle

    # Determine max flight time and create simulation object
    ignition_delay = 5.0  # Time on pad before motor ignites

    if csv_file:
        # CSV mode - detect file type and load
        try:
            # Detect CSV type by reading the header
            with open(csv_file, 'r') as f:
                header_line = f.readline().strip()
                # Flight data CSVs have sensor columns like "BMI088" or actual sensor names
                # OpenRocket CSVs have columns like "Vertical acceleration" or "Altitude (ft)"
                is_flight_data = any(keyword in header_line for keyword in [
                    'BMI088', 'DPS310', 'DPS368', 'MS5611', 'MAX-M10S', 'LIS3MDL',
                    'AccX', 'AccY', 'AccZ', 'GyroX', 'GyroY', 'GyroZ'
                ])

            if is_flight_data:
                print("Detected: Old flight data CSV (using real sensor data)")
                temp_sim = FlightDataSimulation(csv_file, dt, ignition_delay)
            else:
                print("Detected: OpenRocket CSV (using simulated data)")
                temp_sim = CSVSimulation(csv_file, dt, ignition_delay)

            max_time = temp_sim.data['time'][-1] + ignition_delay  # Add ignition delay to total time
            csv_type = 'flight_data' if is_flight_data else 'openrocket'
            del temp_sim  # We'll create a fresh one after warmup
            print(f"CSV flight duration: {max_time:.2f} seconds (includes {ignition_delay:.1f}s ignition delay)")
        except Exception as e:
            print(f"ERROR: Could not load CSV file: {e}")
            sys.exit(1)
    else:
        # Physics mode
        max_time = 20.0  # 20 second flight (after warmup)

    # Track max altitude
    max_altitude = 0.0

    # Debug flag - set to True to see detailed packet data
    verbose = False
    packet_count = 0

    # Data collection for plotting
    time_data: List[float] = []
    sim_alt_data: List[float] = []
    fc_alt_data: List[float] = []

    # Track stage transitions for plotting
    stage_transitions: List[Tuple[float, str]] = []  # List of (time, stage_name)
    last_stage = None

    # Open CSV file for logging telemetry
    csv_log_filename = 'hitl_telemetry_log.csv'
    csv_log_file = open(csv_log_filename, 'w', newline='', encoding='utf-8')
    csv_writer = None  # Will be initialized when we get the header

    # Open text file for logging all FC messages
    fc_log_filename = 'hitl_fc_messages.txt'
    fc_log_file = open(fc_log_filename, 'w', encoding='utf-8')
    print(f"Logging all FC messages to '{fc_log_filename}'")

    # Write CSV header now if we already have it from startup
    if header_columns is not None:
        csv_writer = csv.writer(csv_log_file)
        csv_writer.writerow(['SimTime', 'SimAlt', 'SimVel'] + header_columns)
        print(f"CSV log file initialized with {len(header_columns) + 3} columns")

    # Warmup phase - send stationary data at steady rate while monitoring FC
    print("Warmup phase: Sending stationary data while FC initializes...")
    g = 9.81  # Gravity constant
    warmup_start = time.time()
    warmup_packet_count = 0
    fc_ready = False
    min_warmup_packets = int(warmup_time / dt)  # Minimum packets after FC ready
    packets_since_ready = 0
    warmup_timeout = 10.0  # Timeout after 10 seconds if no FC response

    while (not fc_ready or packets_since_ready < min_warmup_packets) and (time.time() - warmup_start < warmup_timeout):
        loop_start = time.time()

        # Send stationary sensor data
        sensor_data = {
            'timestamp': warmup_packet_count * dt,
            'accel': np.array([0.0, 0.0, g]),  # Just gravity
            'gyro': np.array([0.0, 0.0, 0.0]),
            'mag': np.array([20.0, 10.0, -45.0]),
            'pressure': 1013.25,  # Sea level pressure
            'temperature': 25.0,
            'gps_lat': 45.0,
            'gps_lon': -122.0,
            'gps_alt': 0.0,
            'gps_fix': 1,
            'gps_fix_quality': 8,
            'gps_heading': 0.0
        }

        packet = format_hitl_packet(sensor_data)
        ser.write(packet.encode())
        warmup_packet_count += 1

        # Read any available telemetry (non-blocking)
        while ser.in_waiting:
            line = ser.readline().decode('utf-8', errors='ignore').strip()

            # Log all FC messages to text file
            if line:
                fc_log_file.write(f"[WARMUP {warmup_packet_count*dt:.3f}s] {line}\n")
                fc_log_file.flush()  # Ensure immediate write

            # Check if FC reports it's ready
            if "Flight computer ready" in line or "Ready for simulation" in line:
                if not fc_ready:
                    print(f"  FC ready after {warmup_packet_count} packets! Settling KF for {warmup_time}s...")
                    fc_ready = True
                    packets_since_ready = 0

            # Look for telemetry
            if line.startswith("TELEM/"):
                if 'State - Time (s)' in line or 'State - Flight Stage' in line:
                    # Parse header if we haven't yet
                    if column_map is None:
                        column_map = parse_telem_header(line)
                        header_columns = line[6:].strip().split(',')
                        print(f"  Parsed telemetry header with {len(column_map)} columns")
                        # Initialize CSV with header
                        csv_writer = csv.writer(csv_log_file)
                        csv_writer.writerow(['SimTime', 'SimAlt', 'SimVel'] + header_columns)
                else:
                    # Got telemetry data
                    telem = parse_telem_line(line, column_map)

                    # Log telemetry to CSV during warmup
                    if csv_writer is not None:
                        sim_values = [
                            round((warmup_packet_count - 1) * dt, 2),  # Previous packet time
                            0.00,  # SimAlt = 0 during warmup
                            0.00   # SimVel = 0 during warmup
                        ]
                        csv_writer.writerow(sim_values + telem['values'])

                    # Mark FC as ready on first data telemetry
                    if not fc_ready:
                        print(f"  FC sending telemetry after {warmup_packet_count} packets! Settling KF for {warmup_time}s...")
                        fc_ready = True
                        packets_since_ready = 0
            else:
                # Non-telemetry messages
                if line:  # Only print non-empty lines
                    print(f"[FC] {line}")

        if fc_ready:
            packets_since_ready += 1

        # Show periodic status during warmup
        if warmup_packet_count % 100 == 0:
            elapsed_time = time.time() - warmup_start
            print(f"  Warmup: {warmup_packet_count} packets sent, {elapsed_time:.1f}s elapsed, FC ready: {fc_ready}")

        # Maintain steady timing (50Hz = 20ms per loop)
        elapsed = time.time() - loop_start
        if elapsed < dt:
            time.sleep(dt - elapsed)

    warmup_duration = time.time() - warmup_start

    if not fc_ready:
        print(f"\nWARNING: FC did not respond after {warmup_duration:.1f}s ({warmup_packet_count} packets)")
        print("Proceeding anyway - check that FC is connected and running HITL mode")
    else:
        print(f"Warmup complete! Sent {warmup_packet_count} packets over {warmup_duration:.1f}s")

    # Create simulation based on mode
    if csv_file:
        if csv_type == 'flight_data':
            sim = FlightDataSimulation(csv_file, dt, ignition_delay)
        else:
            sim = CSVSimulation(csv_file, dt, ignition_delay)
        print(f"CSV simulation loaded: {len(sim.data['time'])} data points")
        if sim.data['altitude']:
            print(f"Flight duration: {max_time:.2f}s, Max altitude: {max(sim.data['altitude']):.2f}m")
        else:
            print(f"Flight duration: {max_time:.2f}s")
        print(f"Motor will ignite at t={ignition_delay:.1f}s")
    else:
        sim = RocketSimulation(dt=dt, ignition_delay=ignition_delay)
        print(f"Physics simulation initialized: time={sim.state.time}, altitude={sim.state.position[2]}, velocity={sim.state.velocity[2]}")
        print(f"Motor will ignite at t={ignition_delay:.1f}s")

    print(f"Starting flight simulation...\n")

    # Set up live plotting if requested
    fig = None
    ax = None
    sim_line = None
    fc_line = None
    stage_lines = []
    stage_texts = []

    if live_plot:
        import matplotlib
        matplotlib.use('TkAgg')  # Use non-blocking backend
        plt.ion()  # Turn on interactive mode
        fig, ax = plt.subplots(figsize=(12, 6))
        sim_line, = ax.plot([], [], 'b-', label='Barometer Altitude', linewidth=2)
        fc_line, = ax.plot([], [], 'r--', label='Kalman Filter Estimate', linewidth=2)
        ax.set_xlabel('Time (s)', fontsize=12)
        ax.set_ylabel('Altitude (m)', fontsize=12)
        ax.set_title('Live Altitude: Barometer vs Kalman Filter', fontsize=14, fontweight='bold')
        ax.legend(fontsize=11, loc='upper left')
        ax.grid(True, alpha=0.3)
        fig.canvas.draw()
        fig.canvas.flush_events()
        print("Live plot window opened!")

    try:
        print("Starting main simulation loop...")

        while sim.state.time < max_time:
            loop_start = time.time()

            # Step simulation
            state = sim.step()
            sensor_data = sim.get_sensor_data(state)

            # Send HITL packet
            packet = format_hitl_packet(sensor_data)
            ser.write(packet.encode())
            packet_count += 1

            # Show detailed packet data for first few packets or if verbose
            if verbose or packet_count <= 5:
                print(f"\n>>> SENT TO FC (packet {packet_count}):")
                print(f"    Raw packet: {packet[:100]}...")  # Show first 100 chars
                print(f"    Time: {sensor_data['timestamp']:.3f}s")
                print(f"    Accel: [{sensor_data['accel'][0]:7.2f}, {sensor_data['accel'][1]:7.2f}, {sensor_data['accel'][2]:7.2f}] m/s²")
                print(f"    Pressure: {sensor_data['pressure']:.2f} hPa")
                print(f"    Altitude: {state.position[2]:.2f} m")
                print(f"    Velocity: {state.velocity[2]:.2f} m/s")

            # Read all available telemetry (non-blocking)
            while ser.in_waiting:
                line = ser.readline().decode('utf-8', errors='ignore').strip()

                # Log all FC messages to text file
                if line:
                    fc_log_file.write(f"[{sim.state.time:.3f}s] {line}\n")
                    fc_log_file.flush()  # Ensure immediate write

                if line.startswith("TELEM/"):
                    # Check if this is the header line
                    if 'State - Time (s)' in line or 'State - Flight Stage' in line:
                        column_map = parse_telem_header(line)
                        print(f"\n[HEADER] Parsed telemetry header with {len(column_map)} columns")
                        if verbose:
                            print(f"  Column map: {column_map}")
                        # Initialize CSV writer with header if needed
                        if csv_writer is None:
                            header_line = line[6:].strip()
                            csv_writer = csv.writer(csv_log_file)
                            csv_writer.writerow(['SimTime', 'SimAlt', 'SimVel'] + header_line.split(','))
                    else:
                        # Got telemetry data
                        telem = parse_telem_line(line, column_map)

                        # Extract fields using column mapping if available
                        if column_map and 'fields' in telem:
                            fields = telem['fields']
                        else:
                            fields = {}

                        # Write to CSV
                        if csv_writer is not None:
                            # Use FC barometer altitude as truth for SimAlt column
                            fc_baro_alt = fields.get('HITL_Barometer - Alt ASL (m)', 0.0)
                            sim_values = [
                                round(sim.state.time, 2),
                                round(float(fc_baro_alt) if fc_baro_alt != 'N/A' else 0.0, 2),
                                round(state.velocity[2], 2)
                            ]
                            csv_writer.writerow(sim_values + telem['values'])

                        # Use parsed fields for display and plotting
                        if column_map and fields:
                            fc_time = fields.get('State - Time (s)', 'N/A')
                            fc_stage = fields.get('State - Flight Stage', 'N/A')
                            fc_pz = fields.get('State - PZ (m)', 'N/A')
                            fc_alt = fields.get('HITL_Barometer - Alt ASL (m)', 'N/A')

                            # Collect data for plotting
                            # Use barometer altitude as simulation truth instead of position[2]
                            try:
                                time_data.append(sim.state.time)
                                # Use barometer altitude from FC as the truth
                                sim_alt_data.append(float(fc_alt) if fc_alt != 'N/A' else 0.0)
                                fc_alt_data.append(float(fc_pz) if fc_pz != 'N/A' else 0.0)
                            except (ValueError, IndexError):
                                pass

                            # Show response for first few packets or if verbose
                            if verbose or packet_count <= 3:
                                print(f"<<< RECEIVED FROM FC:")
                                print(f"    FC Time: {fc_time}s")
                                print(f"    Flight Stage: {fc_stage}")
                                print(f"    FC Altitude (Baro): {fc_alt} m")
                                print(f"    FC State PZ (KF): {fc_pz} m")

                            # Only show periodic status updates (every 1 second) or major events
                            # Check for stage changes
                            stage_names = ['PAD', 'BOOST', 'COAST', 'APOGEE', 'EXP_DROGUE',
                                         'DROGUE', 'EXP_MAIN', 'MAIN', 'LANDED']
                            try:
                                stage_name = stage_names[int(float(fc_stage))] if fc_stage != 'N/A' and int(float(fc_stage)) < len(stage_names) else fc_stage
                            except (ValueError, IndexError):
                                stage_name = fc_stage

                            # Detect and record stage changes
                            stage_changed = (last_stage != fc_stage)
                            if stage_changed and last_stage is not None:
                                # Record transition for plotting
                                stage_transitions.append((sim.state.time, stage_name))

                            # Print status every 50 packets (~1 second at 50Hz) or on stage change
                            # Update plot more frequently (every 10 packets = ~0.2 seconds)
                            should_update_plot = (packet_count % 10 == 0) or stage_changed
                            should_print_status = (packet_count % 50 == 0) or stage_changed

                            if should_print_status:
                                # Show pre-launch status differently (both sim types have ignition delay)
                                if sim.state.time < sim.ignition_delay:
                                    status = f"[PAD HOLD - T-{sim.ignition_delay - sim.state.time:.1f}s]"
                                else:
                                    status = f"[{sim.state.time:6.2f}s]"
                                print(f"{status} SimAlt: {state.position[2]:7.2f}m  "
                                      f"KF_PZ: {fc_pz:>7}m  "
                                      f"Vel: {state.velocity[2]:7.2f}m/s  "
                                      f"Stage: {stage_name}")
                                last_stage = fc_stage

                            # Update live plot (more frequently than status printing)
                            if should_update_plot:
                                if live_plot and ax is not None and sim_line is not None and fc_line is not None and fig is not None:
                                    # Update data
                                    sim_line.set_data(time_data, sim_alt_data)
                                    fc_line.set_data(time_data, fc_alt_data)

                                    # Add stage transition line if stage just changed
                                    if stage_changed and last_stage is not None:
                                        stage_colors = {
                                            'PAD': 'gray', 'BOOST': 'green', 'COAST': 'orange',
                                            'APOGEE': 'red', 'EXP_DROGUE': 'purple', 'DROGUE': 'purple',
                                            'EXP_MAIN': 'blue', 'MAIN': 'blue', 'LANDED': 'black'
                                        }
                                        color = stage_colors.get(stage_name, 'gray')
                                        vline = ax.axvline(x=sim.state.time, color=color, linestyle='--', alpha=0.6, linewidth=1.5)
                                        text = ax.text(sim.state.time, ax.get_ylim()[1] * 0.95, stage_name,
                                                      rotation=90, verticalalignment='top', fontsize=9,
                                                      color=color, fontweight='bold')
                                        stage_lines.append(vline)
                                        stage_texts.append(text)

                                    # Auto-scale axes
                                    if time_data:
                                        ax.set_xlim(0, max(time_data) * 1.05)
                                    if sim_alt_data or fc_alt_data:
                                        max_alt = max(max(sim_alt_data) if sim_alt_data else 0,
                                                     max(fc_alt_data) if fc_alt_data else 0)
                                        ax.set_ylim(-10, max_alt * 1.1)

                                    # Redraw
                                    fig.canvas.draw()
                                    fig.canvas.flush_events()
                                    plt.pause(0.001)
                        else:
                            # Fallback if no column map available yet
                            if verbose or packet_count <= 3:
                                print(f"<<< RECEIVED TELEM (no column map yet): {len(telem['values'])} values")
                else:
                    # Non-telemetry messages (events, logs)
                    if line:  # Only print non-empty lines
                        print(f"[FC] {line}")

            # Track max altitude
            if state.position[2] > max_altitude:
                max_altitude = state.position[2]

            # Stop if simulation time exceeds max (don't use altitude-based landing detection for flight data)
            # Flight data CSV may have negative altitudes due to different reference points
            if sim.state.time >= max_time - ignition_delay:
                print("\nReached end of flight data. Ending simulation.")
                break

            # Maintain steady timing (50Hz = 20ms per loop)
            elapsed = time.time() - loop_start
            if elapsed < dt:
                time.sleep(dt - elapsed)

    except KeyboardInterrupt:
        print("\n\nSimulation interrupted by user.")
    finally:
        # Close CSV log file
        csv_log_file.close()
        print(f"\nTelemetry data saved to '{csv_log_filename}'")

        # Close FC message log file
        fc_log_file.close()
        print(f"FC messages saved to '{fc_log_filename}'")

    print("-" * 60)
    print(f"\nSimulation complete!")
    print(f"Max altitude: {max_altitude:.2f} m")
    print(f"Flight time: {sim.state.time:.2f} s")
    print(f"Data points collected: {len(time_data)}")

    ser.close()

    # Plot altitude comparison
    if len(time_data) > 0:
        print("\nGenerating altitude comparison plot...")

        plt.figure(figsize=(12, 6))
        plt.plot(time_data, sim_alt_data, 'b-', label='Barometer Altitude', linewidth=2)
        plt.plot(time_data, fc_alt_data, 'r--', label='Kalman Filter Estimate', linewidth=2)

        # Add vertical lines for stage transitions
        stage_colors = {
            'PAD': 'gray',
            'BOOST': 'green',
            'COAST': 'orange',
            'APOGEE': 'red',
            'EXP_DROGUE': 'purple',
            'DROGUE': 'purple',
            'EXP_MAIN': 'blue',
            'MAIN': 'blue',
            'LANDED': 'black'
        }

        for trans_time, stage_name in stage_transitions:
            color = stage_colors.get(stage_name, 'gray')
            plt.axvline(x=trans_time, color=color, linestyle='--', alpha=0.6, linewidth=1.5)
            # Add text label for the stage
            plt.text(trans_time, plt.ylim()[1] * 0.95, stage_name,
                    rotation=90, verticalalignment='top', fontsize=9,
                    color=color, fontweight='bold')

        plt.xlabel('Time (s)', fontsize=12)
        plt.ylabel('Altitude (m)', fontsize=12)
        plt.title('Altitude Comparison: Barometer vs Kalman Filter', fontsize=14, fontweight='bold')
        plt.legend(fontsize=11, loc='upper left')
        plt.grid(True, alpha=0.3)

        # Add max altitude annotations
        max_sim_alt = max(sim_alt_data) if sim_alt_data else 0
        max_fc_alt = max(fc_alt_data) if fc_alt_data else 0
        stage_count = len(stage_transitions)
        plt.text(0.02, 0.85, f'Max Sim Alt: {max_sim_alt:.2f} m\nMax FC Alt: {max_fc_alt:.2f} m\nStage Transitions: {stage_count}',
                 transform=plt.gca().transAxes, fontsize=10,
                 verticalalignment='top', bbox=dict(boxstyle='round', facecolor='wheat', alpha=0.5))

        plt.tight_layout()
        plt.savefig('hitl_altitude_comparison.png', dpi=150)
        print("Plot saved as 'hitl_altitude_comparison.png'")
        plt.show(block=False)
    else:
        print("\nNo telemetry data received - cannot generate plot.")

if __name__ == "__main__":
    main()
