Terrapin-Rocket-Team/Airbrake/(commit log)

2024-06-21 FlapActuation Optimized Functions
    SAC2024 rewriting air brake code, calculating actuation angle and subsequent functions
2024-07-18 Basic Cad For New Airbrake
    Not sure if we're going to use it but the rude cad is here
    [1434K43_Mounted Roller Bearing with Two-Bolt Flange.prt, 2in Nosecone Tip.prt, 4in straight cone mold.prt, 6071K11_Clevis Rod End.STEP, 6071K11_Clevis Rod End.prt, 6071K11_Clevis Rod End2073.prt, 6338K422_Oil-Embedded Flanged Sleeve Bearing.prt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]
2024-07-29 created motor_parameters
2024-08-28 initial matlab
    [mock_1.csv]
2024-08-28 added motor and drag simulation
    [mock_1.csv]
2024-08-28 added aoa. model comleted
    [mock_1.csv]
2024-08-31 Moved CAD
    [assembly.SLDASM, body_tube.SLDPRT, central_connector.SLDPRT, central_rod.SLDPRT, flap.SLDPRT, new_hinge.SLDPRT, screw.SLDPRT, top_plate.SLDPRT]
2024-09-03 made a rocket type to pass in
    [mock_1.csv]
2024-09-10 got state estimation tester working with open rocket
    [mock_1.csv, openrocket_test_data.csv]
2024-09-12 CAD update
    [11175A12_Strap Hinge.SLDPRT, 1711A13_Black Acetal Plastic Strap Hinge.SLDPRT, Body1.SLDPRT, assembly.SLDASM, body_tube.SLDPRT, body_tube.STEP, central.SLDPRT, central_rod.SLDPRT]
2024-09-17 made kf 6 dimension state w/ 3 meas
    [TADPOL_April_NY_post_processed2.csv, mock_1.csv]
2024-09-17 added meas data
    [mock_1.csv]
2024-09-17 move motor_parameters to head
2024-09-17 Tentative full CAD config
    [gearbox.SLDPRT, half_asm.SLDASM, motor.SLDPRT, motor_driver.SLDPRT]
2024-09-20 flight code that still doesn't build
    [airbrake_state.cpp, airbrake_state.h, main.cpp]
2024-09-20 Revert "Moved CAD"
    This reverts commit 17623fdfb91fb210298f1cc3f48321fa1b9009fc.
    [assembly.SLDASM, body_tube.SLDPRT, central_connector.SLDPRT, central_rod.SLDPRT, flap.SLDPRT, hinge.SLDPRT, new_hinge.SLDPRT, screw.SLDPRT]
2024-09-20 Revert "CAD"
    This reverts commit 8359aeebe09319ea7ef6e981cab92fe88a2f2b34.
    [assembly.SLDASM, body_tube.SLDPRT, central_rod.SLDPRT, hinge.SLDPRT, top_plate.SLDPRT]
2024-09-24 vn brought into mmfs framework
2024-09-24 added wiring images
2024-09-24 got rid of cad
    [Assembly.SLDASM, Bulkhead.SLDPRT, Bulkhead_Top.SLDPRT, Carbon_Fibre_Rod.SLDPRT, Flap_Assembly.SLDASM, Hinge_Bottom.SLDPRT, Hinge_Top.SLDPRT]
2024-09-24 got rid of airbrake cad
    [1434K43_Mounted Roller Bearing with Two-Bolt Flange.prt, 2in Nosecone Tip.prt, 4in straight cone mold.prt, 6071K11_Clevis Rod End.STEP, 6071K11_Clevis Rod End.prt, 6071K11_Clevis Rod End2073.prt, 6338K422_Oil-Embedded Flanged Sleeve Bearing.prt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]
2024-09-24 added the current cad
    [1434K43_Mounted Roller Bearing with Two-Bolt Flange.prt, 2in Nosecone Tip.prt, 4in straight cone mold.prt, 6071K11_Clevis Rod End.STEP, 6071K11_Clevis Rod End.prt, 6071K11_Clevis Rod End2073.prt, 6338K422_Oil-Embedded Flanged Sleeve Bearing.prt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]
2024-09-29 updated airbrake schematic
    [Airbrake_ComputeBoard.kicad_pcb, Airbrake_ComputeBoard.kicad_sch]
2024-09-29 created pcb footprint
    [Airbrake_ComputeBoard.kicad_pcb, Airbrake_ComputeBoard.kicad_sch]
2024-10-01 CAD updates
    [brass_nut.SLDPRT, central.SLDPRT, cf_tubes.SLDPRT, coupler.SLDPRT, inner_coupler_bulkhead.SLDPRT, lead_screw.SLDPRT, linear_crank_bulkhead.SLDPRT, lower_bulkhead.SLDPRT]
2024-10-03 pcb zip
    [Airbrake_ComputeBoard-B_Cu.gbr, Airbrake_ComputeBoard-B_Mask.gbr, Airbrake_ComputeBoard-B_Paste.gbr, Airbrake_ComputeBoard-B_Silkscreen.gbr, Airbrake_ComputeBoard-Edge_Cuts.gbr, Airbrake_ComputeBoard-F_Cu.gbr, Airbrake_ComputeBoard-F_Mask.gbr, Airbrake_ComputeBoard-F_Paste.gbr]
2024-10-06 30k kf sim
    [mock_1.csv, openrocket_2024_30k.csv]
2024-10-10 created motor force script
2024-10-22 Added Teensy footprint with USB headers
2024-10-23 created compute board v1.1
    [Airbrake_ComputeBoard.kicad_pcb, Airbrake_ComputeBoard.kicad_sch]
2024-10-23 Updated level shifter transistors w/ resistors
    Added resistors; changed transistors from PNP to NPN; added pull up resistors to output signals.
    [Airbrake_ComputeBoard.kicad_sch]
2024-10-23 Updated PCB to add resistors to level shifters.
    Updated PCB; Added resistors
    [Airbrake_ComputeBoard.kicad_pcb, Airbrake_ComputeBoard.kicad_sch]
2024-10-23 final gerber generated
    [Airbrake_ComputeBoard-B_Cu.gbr, Airbrake_ComputeBoard-B_Mask.gbr, Airbrake_ComputeBoard-B_Paste.gbr, Airbrake_ComputeBoard-B_Silkscreen.gbr, Airbrake_ComputeBoard-Edge_Cuts.gbr, Airbrake_ComputeBoard-F_Cu.gbr, Airbrake_ComputeBoard-F_Mask.gbr, Airbrake_ComputeBoard-F_Paste.gbr]
2024-10-24 actual ordered board
2024-10-30 kf stuff
    [mock_1.csv]
2024-10-30 added the graph of const motor force, var drag force
2024-11-20 made initial encoder class
2024-11-21 encoder updates
2024-11-22 Copied vectornav library into lib folder and added code to read delta time, theta, and velocity
2024-11-22 Added delta V and delta theta code to VN100 mmfs sensor code
2024-12-04 attached vn100 sensor to state
2024-12-07 flight code. vno100 fixes
    [airbrake_state.cpp, airbrake_state.h, main.cpp, vn_100.cpp, vn_100.h]
2024-12-12 added ability for multiple sensors
    [avionics_12_8_24_post.csv, mock_1.csv]
2024-12-17 Added optocouplers, level shifter, and connector for a limit switch
    [Airbrake_ComputeBoard.kicad_sch]
2024-12-17 Made new PCB
    [Airbrake_ComputeBoard.kicad_pcb, Airbrake_ComputeBoard.kicad_sch]
2024-12-19 state estimation stuff
    [mock_1.csv]
2024-12-19 check and created gerber
    [Airbrake_ComputeBoard-B_Cu.gbr, Airbrake_ComputeBoard-B_Mask.gbr, Airbrake_ComputeBoard-B_Paste.gbr, Airbrake_ComputeBoard-B_Silkscreen.gbr, Airbrake_ComputeBoard-Edge_Cuts.gbr, Airbrake_ComputeBoard-F_Cu.gbr, Airbrake_ComputeBoard-F_Mask.gbr, Airbrake_ComputeBoard-F_Paste.gbr]
2025-01-08 velocity from blueraven
2025-01-10 All sensor values from Blue Raven
2025-02-01 added a function to stop motor before switching directions
2025-02-18 fixed blowing up altitude
    [mock_1.csv]
2025-02-22 added ekf
    [mock_1.csv]
2025-02-23 initial airbrake kalman filter implemented
2025-02-23 added outlier rejection to the kalman filter
    making an mmfs issue for this to be done correctly
    [airbrake_state.cpp, airbrake_state.h]
2025-02-24 input velocity of calc actuation angle
2025-02-24 Body Frame
2025-02-26 reviewed body frame transition
2025-02-26 Added files for wiring diagram.
    [Airbrake.bom.tsv]
2025-02-28 initial limit switch stuff
2025-02-28 fixed limit switch zeroing problem
    [airbrake_state.cpp]
2025-02-28 updated zero motor function to the circular buffer thingy
2025-02-28 encoder stuff
2025-03-01 updated stop to stall condition. can't have limit switch prevent moving flaps out
    [airbrake_state.cpp, airbrake_state.h, main.cpp]
2025-03-01 set max flap angle to 70 and fixed crashing
    [airbrake_state.cpp, main.cpp]
2025-03-10 Added code to prevent NaN values and replace them with approximation until the issue is resolved
    [airbrake_state.cpp]
2025-03-11 Create sample
2025-03-22 added old flight data
    [1_12_25_Airbrake_FlightData.csv, 3_2_25_Airbrake_FlightData.csv]
2025-03-27 commiting to fix esp things
    [airbrake_state.cpp, airbrake_state.h, main.cpp, simulation.py, vn_100.cpp, vn_100.h]
2025-03-27 Try to fix BT
    [main.cpp]
2025-03-28 fixed blue raven data values
    [main.cpp, vn_100.h]
2025-03-28 try to fix bluetooth
    [main.cpp]
2025-03-29 trying to fix bluetooth
    [airbrake_state.cpp, main.cpp]
2025-03-29 fix vn100 and Message conflict
    [airbrake_state.cpp, airbrake_state.h, main.cpp, vn_100.cpp]
2025-04-30 cleanup cad to archive and wrote flap force in python
    [11175A12_Strap Hinge.SLDPRT, 1434K43_Mounted Roller Bearing with Two-Bolt Flange.prt, 1711A13_Black Acetal Plastic Strap Hinge.SLDPRT, 2in Nosecone Tip.prt, 4in straight cone mold.prt, 6071K11_Clevis Rod End.STEP, 6071K11_Clevis Rod End.prt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]
2025-04-30 HITL flight software and data plotting
    [1_FlightData.csv, 1_PreFlightData.csv, 37_FlightData.csv, 37_PreFlightData.csv, 39_FlightData.csv, 39_PreFlightData.csv, 4_FlightData.csv, 4_PreFlightData.csv]
2025-04-30 final hitl testing
    [1_FlightData.csv, 1_PreFlightData.csv, 37_FlightData.csv, 37_PreFlightData.csv, 39_FlightData.csv, 39_PreFlightData.csv, 4_FlightData.csv, 4_PreFlightData.csv]
2025-05-14 Changed arduino string to std string
2025-05-14 Added motor speed variable in AirbreakState
2025-05-14 Added motorSpeed variable in airbrake_state.cpp
2025-05-22 some full interior hitl runs
    [5-22-25_Interior_Full.csv, 5-22-25_No_Flap.csv]
2025-05-25 fix CdA estimation and add better drag calculation
    [5-25-25_fixed_CdA_estimation.csv]
2025-05-25 added mock blue raven and pressure increase shock to simulation
2025-05-31 added simple supersonic filter - complex ekf commented out
    [5-31-25_supersonic_not_accounted_for.csv, 5-31-25_supersonic_simple_filter.csv]
2025-06-01 fuck myself we stink
    [52_FlightData.csv, 52_PreFlightData.csv, 55_FlightData.csv, 55_PreFlightData.csv, 58_FlightData.csv, 58_PreFlightData.csv]
2025-06-09 airbrake monte carlo and flight code
    [269_FlightData.csv, 269_PreFlightData.csv, 52_FlightData.csv, 52_PreFlightData.csv, 55_FlightData.csv, 55_PreFlightData.csv, 58_FlightData.csv, 58_PreFlightData.csv]
2025-06-10 bluetooth ready to go?
    [297_PreFlightData.csv, 6-8-25_ideal_full_flight.csv]
2025-06-10 added barometric error correction
    [flight_data.csv]
2025-06-11 final flight code
    [269_FlightData.csv, 269_PreFlightData.csv, 297_PreFlightData.csv, 6-10-25_final_simulation.csv]
2025-06-12 flap force stuff with new stronger motor
2025-10-07 basic motordriver object
2025-12-13 Motor Works
2026-01-02 hitl testing
    [hitl_telemetry_log.csv]
2026-01-20 HITL testing improvements
    [28_FlightData_with_pre.csv, hitl_telemetry_log.csv]
2026-02-02 fixes to get ready for integration
    [fix_odrive_debug.py, main.cpp, md6.h]
2026-02-13 feat(airbrake): integrate SITL airbrake sim and native motor mock
