Terrapin-Rocket-Team/Airbrake/vn_100/teensy_wiring.JPG

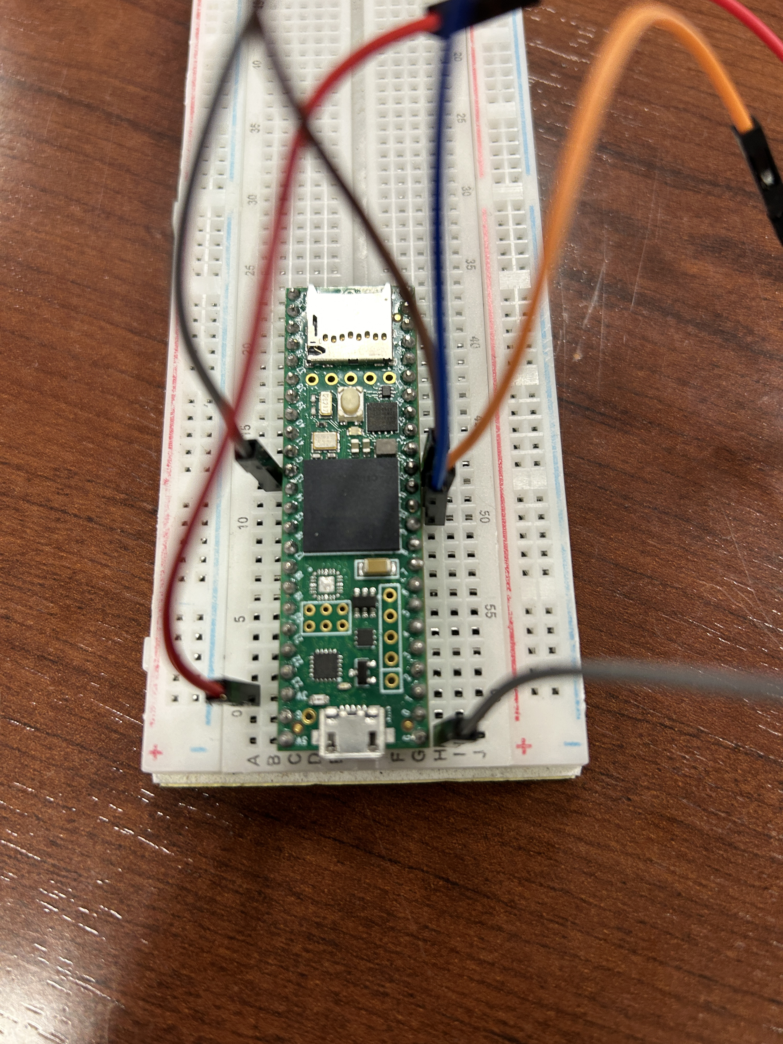
vn_100/teensy_wiring.JPG
