Terrapin-Rocket-Team/Airbrake/vn_100/vn100_wiring.JPG

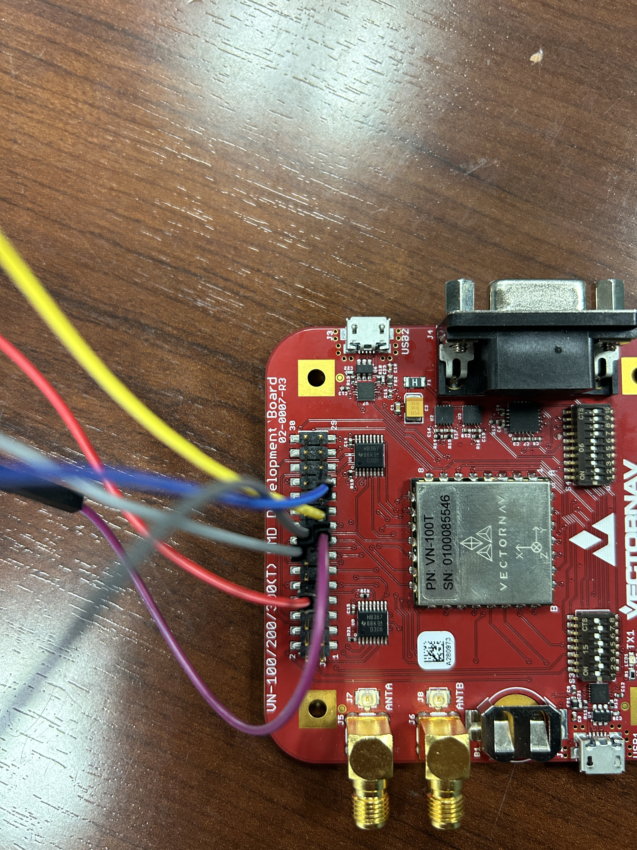
vn_100/vn100_wiring.JPG
